digamesystems/HD_Remote_Clone/docs/images/enclosure/enclosure_pcb_outline.dxf

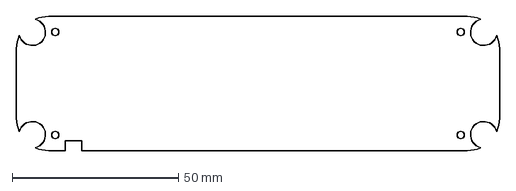
[picture p13: CAD file, 2026-11-13]
docs/images/enclosure/enclosure_pcb_outline.dxf
145.4 x 40.4 mm
