digamesystems/HD_Remote_Clone/TESTING.md

# Testing

Tests are split into three tiers by what they need to run. That decides when they can block a deploy.

## Tier 1: host unit tests (no hardware)

```
pio test -e native
```

These run on the PC with Unity and the MSYS2 gcc compiler, and take seconds. They cover hardware-independent logic in [`lib/hdcore/`](lib/hdcore/src), which the firmware and the tests share.

| Suite | Covers |
|---|---|
| `test_native_parse` | serial command tokenizing, hex parsing, data-rate parsing |
| `test_native_rf` | nRF24 on-air ↔ register address byte order, sniffer duplicate filter, Platinum RF payload decoding, packet runs (counts, gaps, idle flush, `micros()` wrap) |
| `test_native_ir` | HD IR frame encode/decode: layout, period, round trip of all 16 codes, decoding of real captured frames (including phase-shifted and truncated ones) |

**Rule:** logic that can run without hardware goes in `lib/hdcore/`, with a Tier 1 test, rather than in `src/`. This includes protocol encoding, IR frame analysis and state machines.

## Tier 2: on-device tests (ESP32, extra hardware optional)

```
pio test -e esp32dev_test --upload-port COM11                         # all device suites
pio test -e esp32dev_test --upload-port COM11 -f test_device_ir       # one suite
```

These flash a **test firmware** to the board, run Unity on it and report over serial. Afterwards the board is left running the test firmware, so re-upload the app (`pio run -t upload`).

[`include/hw_config.h`](include/hw_config.h) declares what's wired on the breadboard:

- Hardware declared **absent**: the test is **IGNORED** and reported as *not verified*.
- Hardware declared **present**: the test **must pass**. A failure blocks deploy.

Update `hw_config.h` whenever the breadboard changes. We can add loopbacks or other diagnostic wiring to make hardware testable.

| Suite | Needs | Covers |
|---|---|---|
| `test_device_board` | board only | chip is the original ESP32 (D0WD), no PSRAM (so not WROVER), flash ≥ 4 MB |
| `test_device_rf` | `HW_NRF24` (+ `HW_NRF24_B` for loopback) | `begin()`, `isChipConnected()`, 200× register read-back at 1 and 2 Mbps, Platinum RX config applies; loopback: radio B → main radio at the Platinum settings, ≥ 45/50 packets on each of ch 33, 52, 71 |
| `test_device_ir` | `HW_IR_LOOPBACK` | TSAL6200 → receiver round trip of a synthetic frame within ±max(200 µs, 25%); 10/10 reliability; HD UP/DOWN bursts decode correctly |

A loopback between two clone modules shows the sniffer works, but not that it hears the original remote, whose frames may differ in detail; acceptance A4 (group-mode sniff) is the real check. Planned: button and deep-sleep wake tests (`HW_BUTTONS`).

**Implementation note:** `pio test` defines `UNIT_TEST`, which switches IRremoteESP8266 into a host-stub mode. [`scripts/no_unit_test_define.py`](scripts/no_unit_test_define.py) strips that define for the ESP32 environments so device tests use the real library.

## Tier 3: manual acceptance (real shades, original remote)

These can't be automated. A feature is **done** once John confirms it and it's recorded below.

| # | Check | Result | Date |
|---|---|---|---|
| A1 | Capture IR from the original remote in red mode, every button | ✅ Format decoded; UP = 0101, DOWN = 0110 (log + analyzer); no other button sends IR (analyzer) | 2026-11-07 |
| A2 | Replay a captured IR code; target shade responds | ✅ With the original remote's RF present (remote aimed away): shade moves both ways and follows the clone when the two disagree. Clone alone: 0 of 20 (see docs/IR_PROTOCOL.md, Shade tests) | 2026-11-09 |
| A3 | RF scan shows the original remote's channels | ⏳ ch 33 confirmed by exact-match sniff (both remotes); 52 / 71 not checked; `scan` not run | 2026-11-11 |
| A4 | Sniffer decodes the original remote's group up/down/release packets | ⏳ group 1 UP held + release decoded from both remotes (docs/RF_PROTOCOL.md). DOWN not sniffed | 2026-11-11 |
| A6 | Clone RF group commands move the shades | ✅ `grp`: groups 1–4 independently and All, UP and DOWN, no original remote | 2026-11-11 |
| A7 | Clone pairs with a shade under its own ID | ⏳ `pair 4 add` with a made-up ID: the shade jogged, then `grp 4` worked 5/5 up and 5/5 down (none before pairing). `pair 4 remove` not tested | 2026-11-12 |
| A5 | RF-wake hypothesis: IR replay alone vs. with RF burst | ✅ Confirmed by two tests: clone IR alone 0/20, clone IR + remote RF works; remote's IR fails when a foil tube blocks its RF. RF captured 2026-11-11 (`ID 01 00 80`, docs/RF_PROTOCOL.md); our own wake + IR moves the shade with no original remote, reliably at ~1 ft (2026-11-11) | 2026-11-11 |

## Gate rules

Day-to-day development uses fast, ungated steps; the full gate runs on a release (`cpdt`). The shorthand commands are defined in [CLAUDE.md](CLAUDE.md).

| Step | Must pass |
|---|---|
| Deploy for a quick try (`d`) | `pio run` builds (no tests) |
| Commit (`c`) | `pio run` builds (no tests) |
| **Gated release (`cpdt`)** | build + **all** Tier 1 suites + Tier 2 suites for `board` and the areas changed (`-f test_device_<area>`), then commit, push and upload the app |
| Feature "done" | its Tier 3 row confirmed |

Ungated commits may reach GitHub between releases; `cpdt` is what certifies a build. If any required step fails: **halt**. No commit, push or deploy. Report the failure.

If Tier 2 tests are ignored because hardware is absent, the build may still be deployed, but the report must say plainly which areas were **not verified**.
