digamesystems/HD_Remote_Clone/hardware/hd_remote/hd_remote.kicad_pcb

## KiCad design hardware/hd_remote/hd_remote.kicad_pcb (2026-11-14)

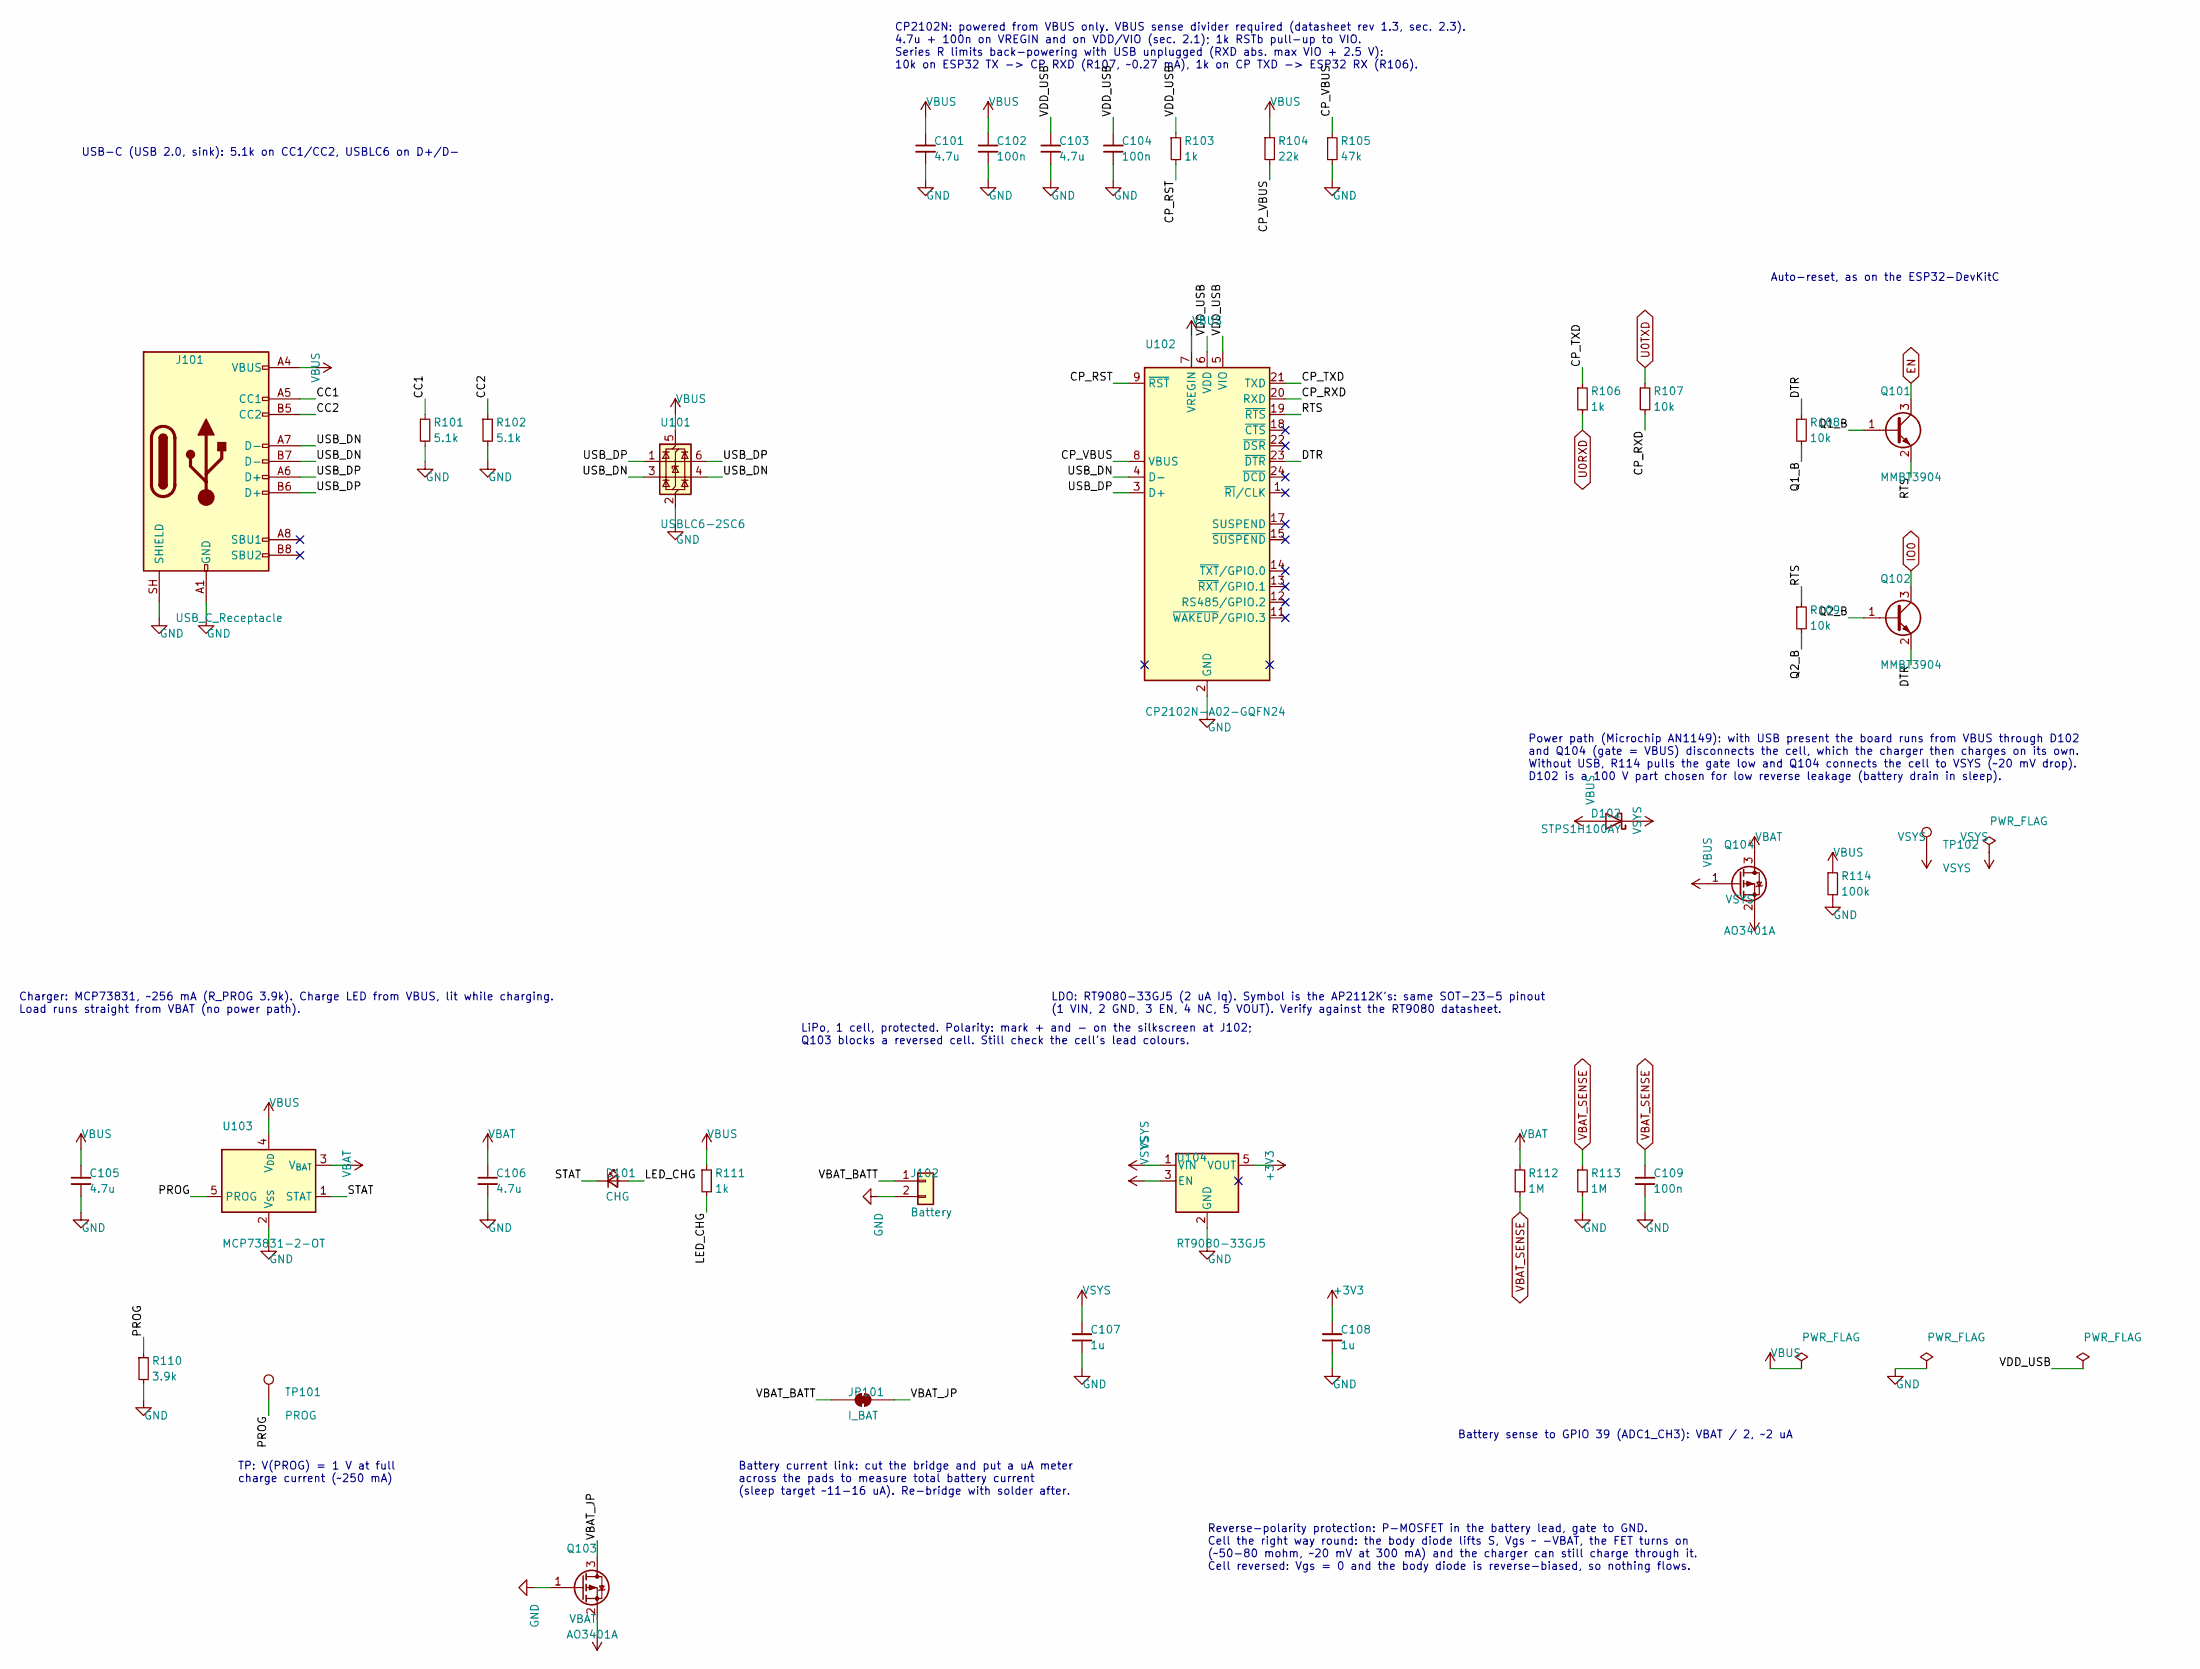
[picture p15: schematic power_usb.kicad_sch, HD Platinum remote replacement: Power and USB]

Parts:
C101, C103, C105, C106: 4.7u; C_0603_1608Metric; LCSC C19666
C102, C104, C109: 100n; C_0603_1608Metric; LCSC C14663
C107, C108: 1u; C_0603_1608Metric; LCSC C15849
D101: CHG; LED_0603_1608Metric; LCSC C2286
D102: STPS1H100AY; D_SMA; MPN STPS1H100AY; LCSC C181833
J101: USB_C_Receptacle; USB_C_Receptacle_HRO_TYPE-C-31-M-12; LCSC C165948
J102: Battery; JST_PH_S2B-PH-K_1x02_P2.00mm_Horizontal; LCSC C173752
JP101: I_BAT; SolderJumper-2_P1.3mm_Bridged_RoundedPad1.0x1.5mm
Q101, Q102: MMBT3904; SOT-23; LCSC C20526
Q103, Q104: AO3401A; SOT-23; LCSC C15127
R101, R102: 5.1k; R_0603_1608Metric; LCSC C23186
R103, R106, R111: 1k; R_0603_1608Metric; LCSC C21190
R104: 22k; R_0603_1608Metric; LCSC C31850
R105: 47k; R_0603_1608Metric; LCSC C25819
R107, R108, R109: 10k; R_0603_1608Metric; LCSC C25804
R110: 3.9k; R_0603_1608Metric; LCSC C23018
R112, R113: 1M; R_0603_1608Metric; LCSC C22935
R114: 100k; R_0603_1608Metric; LCSC C25803
TP101: PROG; TestPoint_Pad_D1.5mm
TP102: VSYS; TestPoint_Pad_D1.5mm
U101: USBLC6-2SC6; SOT-23-6; LCSC C7519
U102: CP2102N-A02-GQFN24; QFN-24-1EP_4x4mm_P0.5mm_EP2.6x2.6mm; LCSC C969151
U103: MCP73831-2-OT; SOT-23-5; LCSC C424093
U104: RT9080-33GJ5; SOT-23-5; LCSC C841192

Connections:
+3V3: C108.1, U104.5 (VOUT); also elsewhere on the board
/Power and USB/CC1: J101.A5 (CC1), R101.1
/Power and USB/CC2: J101.B5 (CC2), R102.1
/Power and USB/CP_RST: R103.2, U102.9 (~RST)
/Power and USB/CP_RXD: R107.2, U102.20 (RXD)
/Power and USB/CP_TXD: R106.1, U102.21 (TXD)
/Power and USB/CP_VBUS: R104.2, R105.1, U102.8 (VBUS)
/Power and USB/DTR: Q102.2 (E), R108.1, U102.23 (~DTR)
/Power and USB/LED_CHG: D101.2 (A), R111.2
/Power and USB/PROG: R110.1, TP101.1, U103.5 (PROG)
/Power and USB/Q1_B: Q101.1 (B), R108.2
/Power and USB/Q2_B: Q102.1 (B), R109.2
/Power and USB/RTS: Q101.2 (E), R109.1, U102.19 (~RTS)
/Power and USB/STAT: D101.1 (K), U103.1 (STAT)
/Power and USB/USB_DN: J101.A7 (D-), J101.B7 (D-), U101.3 (I/O2), U101.4 (I/O2), U102.4 (D-)
/Power and USB/USB_DP: J101.A6 (D+), J101.B6 (D+), U101.1 (I/O1), U101.6 (I/O1), U102.3 (D+)
/Power and USB/VBAT_BATT: J102.1, JP101.1 (A)
/Power and USB/VBAT_JP: JP101.2 (B), Q103.3 (D)
/Power and USB/VDD_USB: C103.1, C104.1, R103.1, U102.5 (VIO), U102.6 (VDD)
EN: Q101.3 (C); also elsewhere on the board
GND: C101.2, C102.2, C103.2, C104.2, C105.2, C106.2, C107.2, C108.2, C109.2, J101.A1 (GND), J101.A12 (GND), J101.B1 (GND), J101.B12 (GND), J101.SH (SHIELD), J102.2, Q103.1 (G), R101.2, R102.2, R105.2, R110.2, R113.2, R114.2, U101.2 (GND), U102.2 (GND), U102.25 (GND), U103.2 (V_{SS}), U104.2 (GND); also elsewhere on the board
IO0: Q102.3 (C); also elsewhere on the board
U0RXD: R106.2; also elsewhere on the board
U0TXD: R107.1; also elsewhere on the board
VBAT: C106.1, Q103.2 (S), Q104.3 (D), R112.1, U103.3 (V_{BAT}); also elsewhere on the board
VBAT_SENSE: C109.1, R112.2, R113.1; also elsewhere on the board
VBUS: C101.1, C102.1, C105.1, D102.2 (A), J101.A4 (VBUS), J101.A9 (VBUS), J101.B4 (VBUS), J101.B9 (VBUS), Q104.1 (G), R104.1, R111.1, R114.1, U101.5 (VBUS), U102.7 (VREGIN), U103.4 (V_{DD}); also elsewhere on the board
VSYS: C107.1, D102.1 (K), Q104.2 (S), TP102.1, U104.1 (VIN), U104.3 (EN); also elsewhere on the board

Notes on the sheet:
Reverse-polarity protection: P-MOSFET in the battery lead, gate to GND. Cell the right way round: the body diode lifts S, Vgs ~ -VBAT, the FET turns on (~50-80 mohm, ~20 mV at 300 mA) and the charger can still charge through it. Cell reversed: Vgs = 0 and the body diode is reverse-biased, so nothin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
Battery current link: cut the bridge and put a uA meter across the pads to measure total battery current (sleep target ~11-16 uA). Re-bridge with solder after.
CP2102N: powered from VBUS only. VBUS sense divider required (datasheet rev 1.3, sec. 2.3). 4.7u + 100n on VREGIN and on VDD/VIO (sec. 2.1); 1k RSTb pull-up to VIO. Series R limits back-powering with USB unplugged (RXD abs. max VIO + 2.5 V): 10k on ESP32 TX -> CP RXD (R107, ~0.27 mA), 1k on CP TXD 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
Auto-reset, as on the ESP32-DevKitC
Charger: MCP73831, ~256 mA (R_PROG 3.9k). Charge LED from VBUS, lit while charging. Load runs straight from VBAT (no power path).
Power path (Microchip AN1149): with USB present the board runs from VBUS through D102 and Q104 (gate = VBUS) disconnects the cell, which the charger then charges on its own. Without USB, R114 pulls the gate low and Q104 connects the cell to VSYS (~20 mV drop). D102 is a 100 V part chosen for low re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
USB-C (USB 2.0, sink): 5.1k on CC1/CC2, USBLC6 on D+/D-
LiPo, 1 cell, protected. Polarity: mark + and - on the silkscreen at J102; Q103 blocks a reversed cell. Still check the cell's lead colours.
Battery sense to GPIO 39 (ADC1_CH3): VBAT / 2, ~2 uA
LDO: RT9080-33GJ5 (2 uA Iq). Symbol is the AP2112K's: same SOT-23-5 pinout (1 VIN, 2 GND, 3 EN, 4 NC, 5 VOUT). Verify against the RT9080 datasheet.
TP: V(PROG) = 1 V at full charge current (~250 mA)

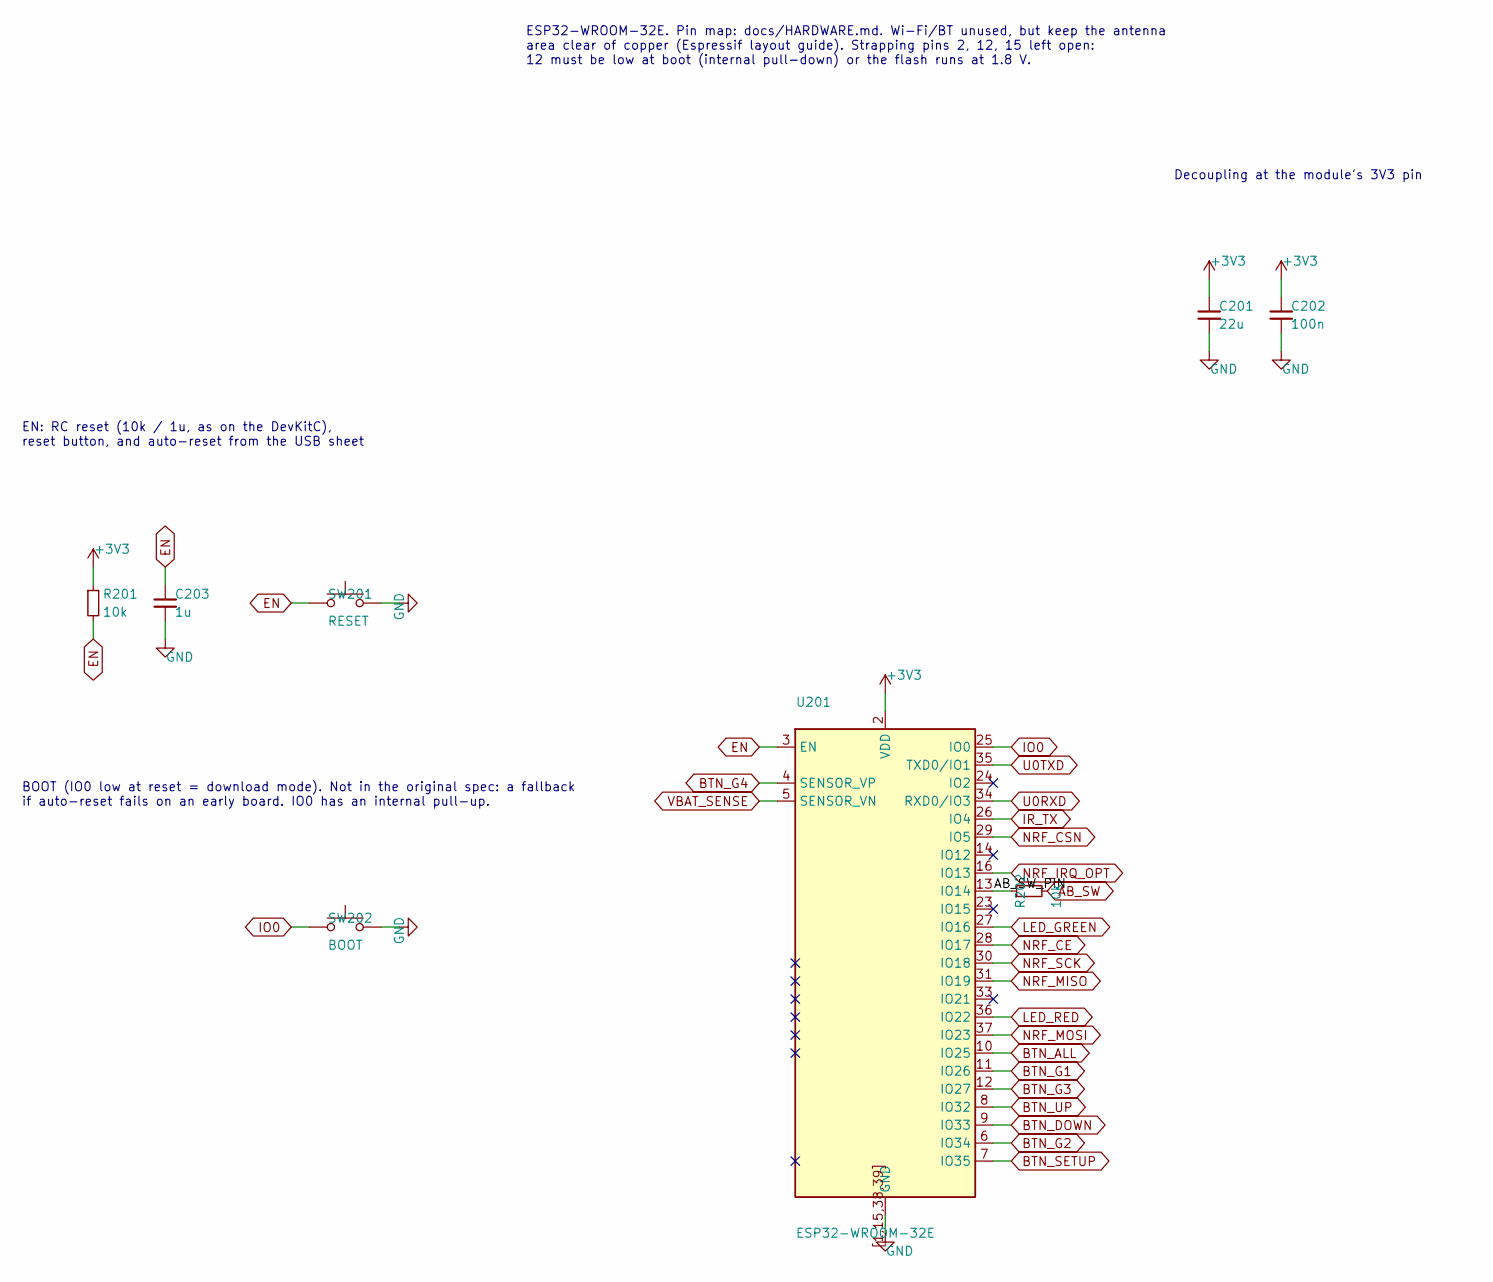
[picture p16: schematic mcu.kicad_sch, HD Platinum remote replacement: MCU]

Parts:
C201: 22u; C_0805_2012Metric; LCSC C45783
C202: 100n; C_0603_1608Metric; LCSC C14663
C203: 1u; C_0603_1608Metric; LCSC C15849
R201, R202: 10k; R_0603_1608Metric; LCSC C25804
SW201: RESET; SW_Push_1P1T_NO_CK_KMR2; LCSC C269272
SW202: BOOT; SW_Push_1P1T_NO_CK_KMR2; LCSC C269272
U201: ESP32-WROOM-32E; LCSC C701341

Connections:
+3V3: C201.1, C202.1, R201.1, U201.2 (VDD); also elsewhere on the board
/MCU/AB_SW_PIN: R202.1, U201.13 (IO14)
AB_SW: R202.2; also elsewhere on the board
BTN_ALL: U201.10 (IO25); also elsewhere on the board
BTN_DOWN: U201.9 (IO33); also elsewhere on the board
BTN_G1: U201.11 (IO26); also elsewhere on the board
BTN_G2: U201.6 (IO34); also elsewhere on the board
BTN_G3: U201.12 (IO27); also elsewhere on the board
BTN_G4: U201.4 (SENSOR_VP); also elsewhere on the board
BTN_SETUP: U201.7 (IO35); also elsewhere on the board
BTN_UP: U201.8 (IO32); also elsewhere on the board
EN: C203.1, R201.2, SW201.1, U201.3 (EN); also elsewhere on the board
GND: C201.2, C202.2, C203.2, SW201.2, SW202.2, U201.1, U201.15, U201.38, U201.39, U201.[1,15,38,39] (GND); also elsewhere on the board
IO0: SW202.1, U201.25 (IO0); also elsewhere on the board
IR_TX: U201.26 (IO4); also elsewhere on the board
LED_GREEN: U201.27 (IO16); also elsewhere on the board
LED_RED: U201.36 (IO22); also elsewhere on the board
NRF_CE: U201.28 (IO17); also elsewhere on the board
NRF_CSN: U201.29 (IO5); also elsewhere on the board
NRF_IRQ_OPT: U201.16 (IO13); also elsewhere on the board
NRF_MISO: U201.31 (IO19); also elsewhere on the board
NRF_MOSI: U201.37 (IO23); also elsewhere on the board
NRF_SCK: U201.30 (IO18); also elsewhere on the board
U0RXD: U201.34 (RXD0/IO3); also elsewhere on the board
U0TXD: U201.35 (TXD0/IO1); also elsewhere on the board
VBAT_SENSE: U201.5 (SENSOR_VN); also elsewhere on the board

Notes on the sheet:
EN: RC reset (10k / 1u, as on the DevKitC), reset button, and auto-reset from the USB sheet
Decoupling at the module's 3V3 pin
BOOT (IO0 low at reset = download mode). Not in the original spec: a fallback if auto-reset fails on an early board. IO0 has an internal pull-up.
ESP32-WROOM-32E. Pin map: docs/HARDWARE.md. Wi-Fi/BT unused, but keep the antenna area clear of copper (Espressif layout guide). Strapping pins 2, 12, 15 left open: 12 must be low at boot (internal pull-down) or the flash runs at 1.8 V.

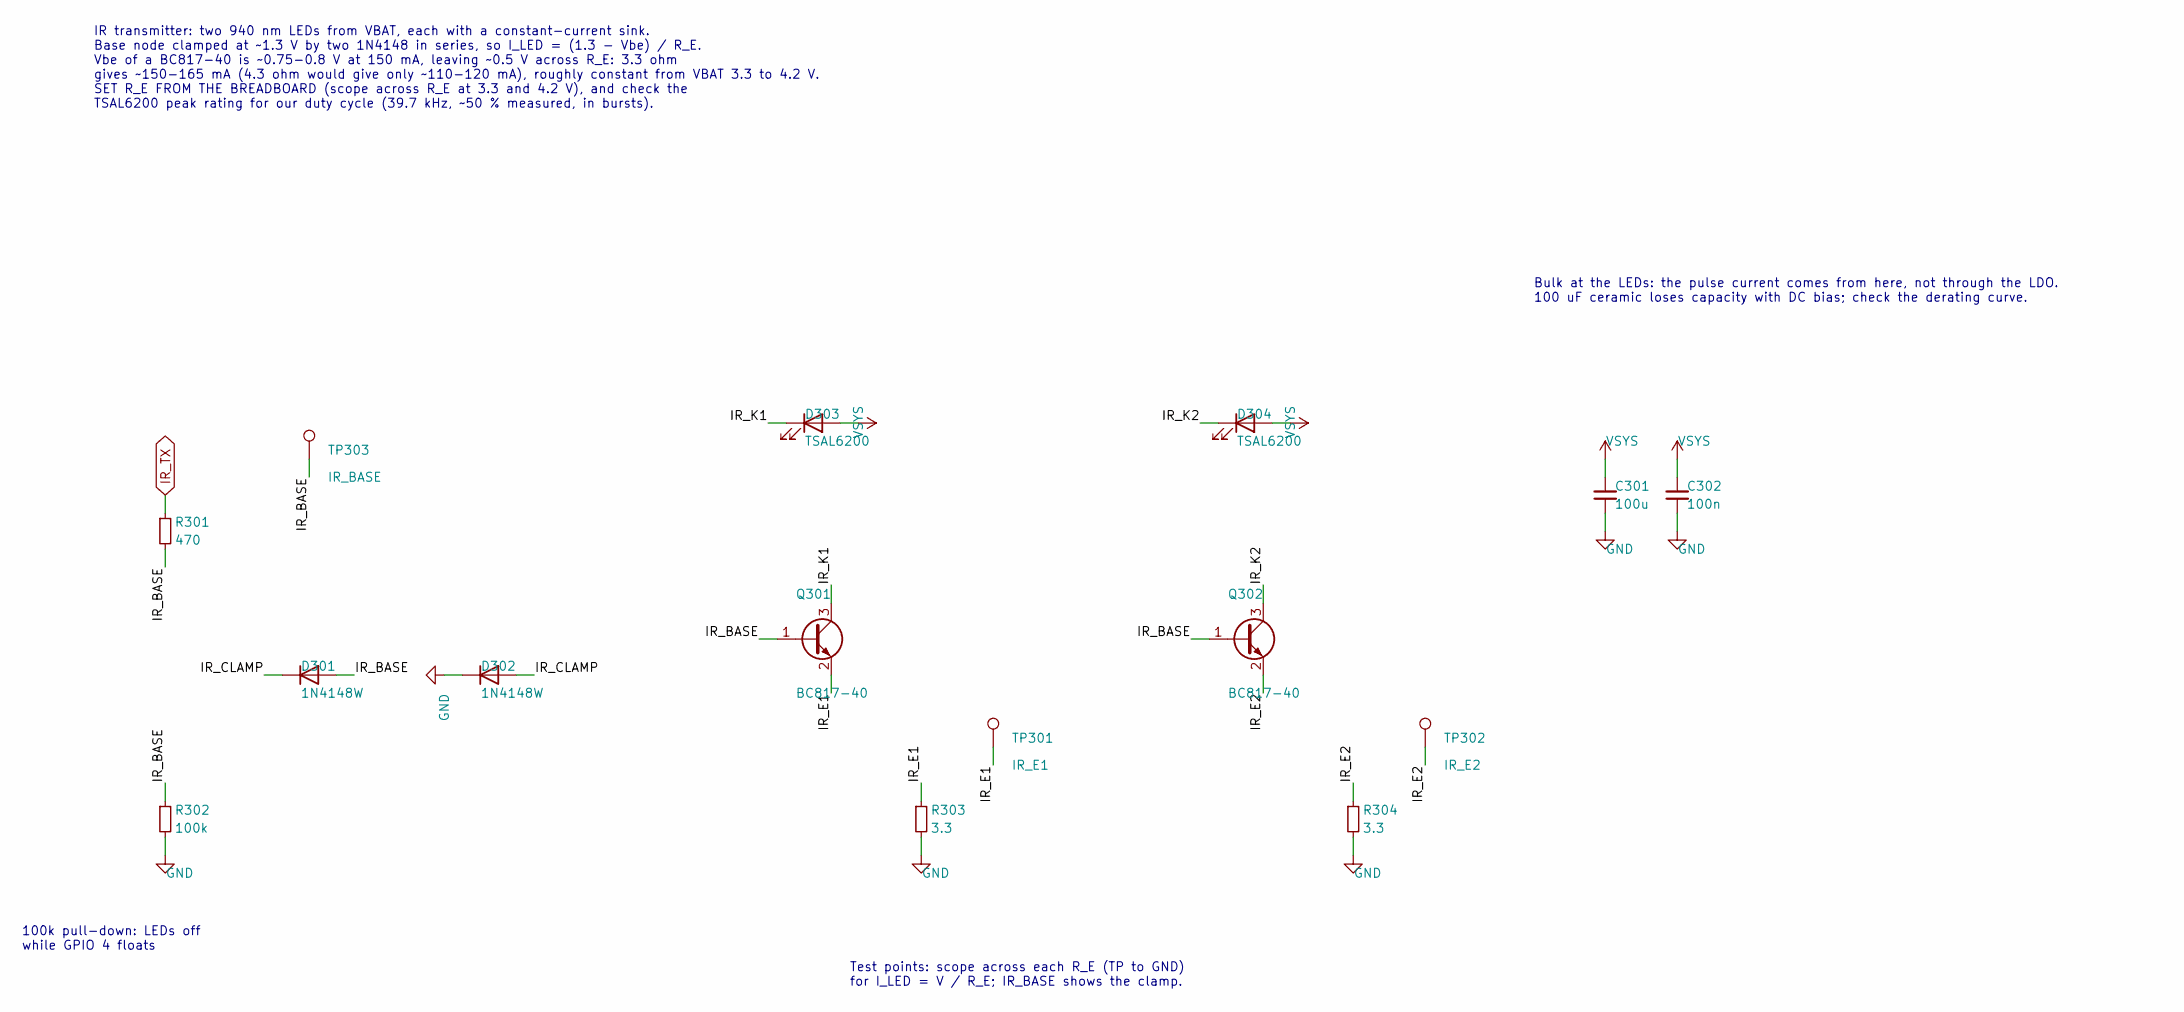
[picture p17: schematic ir.kicad_sch, HD Platinum remote replacement: IR]

Parts:
C301: 100u; C_1206_3216Metric; LCSC C15008
C302: 100n; C_0603_1608Metric; LCSC C14663
D301, D302: 1N4148W; D_SOD-123; LCSC C81598
D303, D304: TSAL6200; LED_D5.0mm_Horizontal_O1.27mm_Z3.0mm
Q301, Q302: BC817-40; SOT-23; LCSC C52801
R301: 470; R_0603_1608Metric; LCSC C23179
R302: 100k; R_0603_1608Metric; LCSC C25803
R303, R304: 3.3; R_0805_2012Metric; LCSC C2907250
TP301: IR_E1; TestPoint_Pad_D1.5mm
TP302: IR_E2; TestPoint_Pad_D1.5mm
TP303: IR_BASE; TestPoint_Pad_D1.5mm

Connections:
/IR/IR_BASE: D301.2 (A), Q301.1 (B), Q302.1 (B), R301.2, R302.1, TP303.1
/IR/IR_CLAMP: D301.1 (K), D302.2 (A)
/IR/IR_E1: Q301.2 (E), R303.1, TP301.1
/IR/IR_E2: Q302.2 (E), R304.1, TP302.1
/IR/IR_K1: D303.1 (K), Q301.3 (C)
/IR/IR_K2: D304.1 (K), Q302.3 (C)
GND: C301.2, C302.2, D302.1 (K), R302.2, R303.2, R304.2; also elsewhere on the board
IR_TX: R301.1; also elsewhere on the board
VSYS: C301.1, C302.1, D303.2 (A), D304.2 (A); also elsewhere on the board

Notes on the sheet:
100k pull-down: LEDs off while GPIO 4 floats
IR transmitter: two 940 nm LEDs from VBAT, each with a constant-current sink. Base node clamped at ~1.3 V by two 1N4148 in series, so I_LED = (1.3 - Vbe) / R_E. Vbe of a BC817-40 is ~0.75-0.8 V at 150 mA, leaving ~0.5 V across R_E: 3.3 ohm gives ~150-165 mA (4.3 ohm would give only ~110-120 mA), ro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
Test points: scope across each R_E (TP to GND) for I_LED = V / R_E; IR_BASE shows the clamp.
Bulk at the LEDs: the pulse current comes from here, not through the LDO. 100 uF ceramic loses capacity with DC bias; check the derating curve.

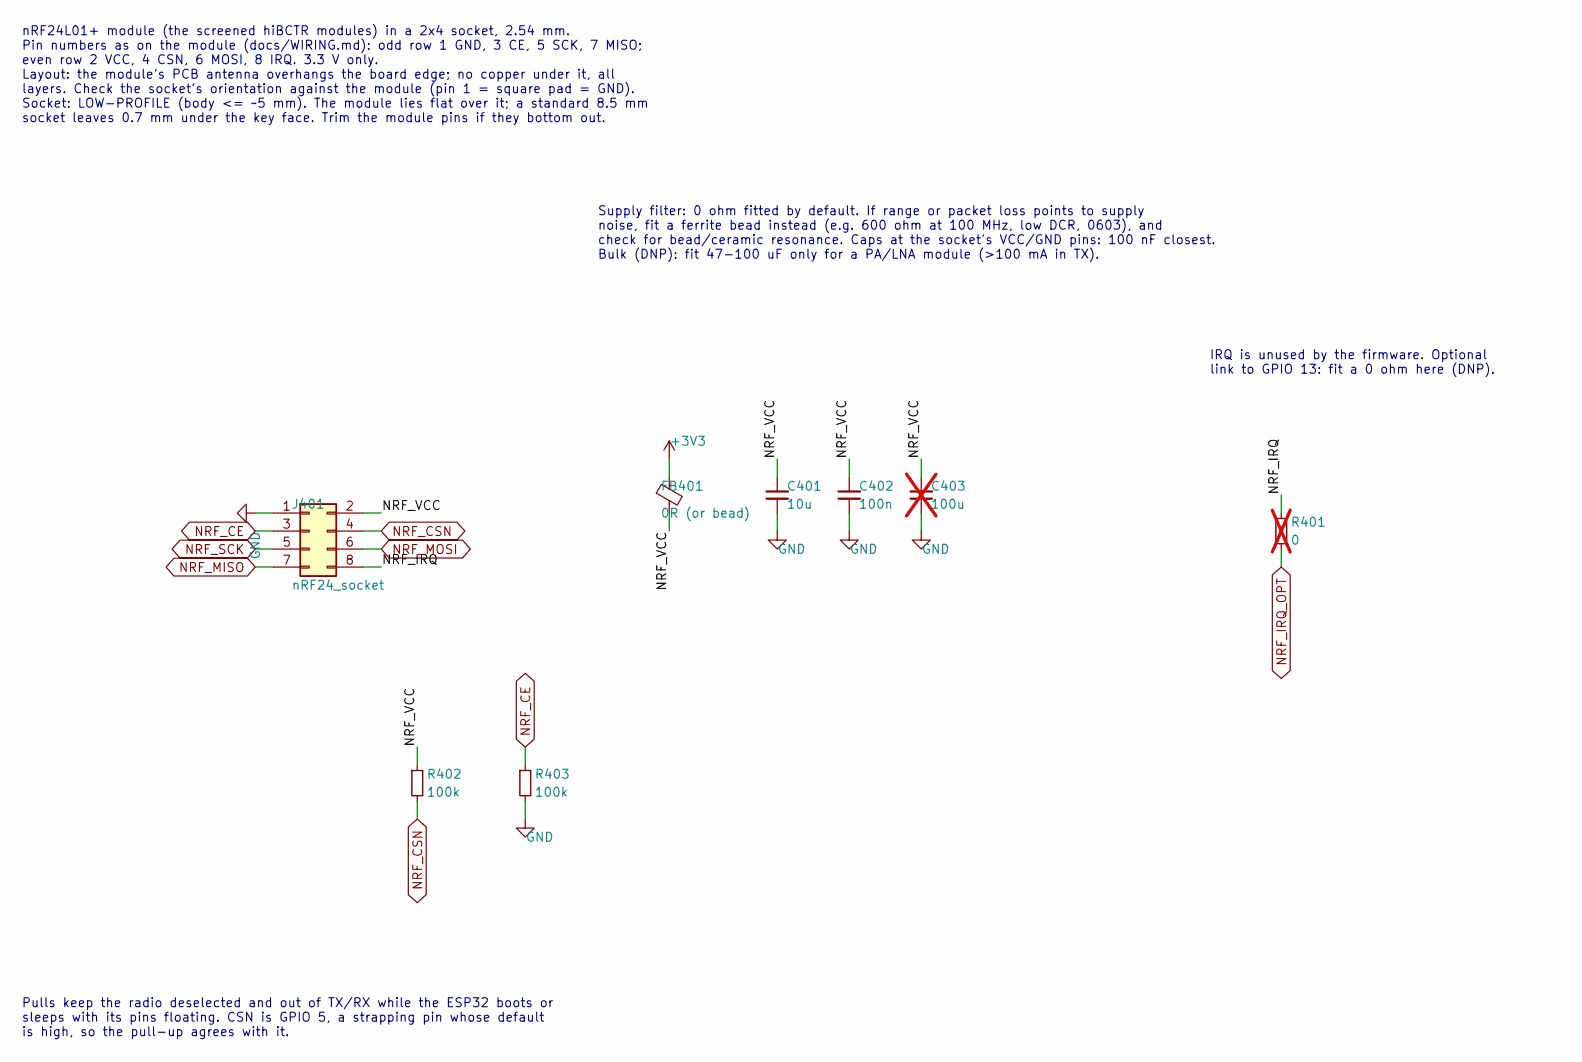
[picture p18: schematic nrf24.kicad_sch, HD Platinum remote replacement: nRF24]

Parts:
C401: 10u; C_0805_2012Metric; LCSC C15850
C402: 100n; C_0603_1608Metric; LCSC C14663
C403: 100u; C_1206_3216Metric; LCSC C15008; not fitted
FB401: 0R (or bead); L_0603_1608Metric; LCSC C21189
J401: nRF24_socket; PinSocket_2x04_P2.54mm_Vertical
R401: 0; R_0603_1608Metric; LCSC C21189; not fitted
R402, R403: 100k; R_0603_1608Metric; LCSC C25803

Connections:
+3V3: FB401.1; also elsewhere on the board
/nRF24/NRF_IRQ: J401.8, R401.1
/nRF24/NRF_VCC: C401.1, C402.1, C403.1, FB401.2, J401.2, R402.1
GND: C401.2, C402.2, C403.2, J401.1, R403.2; also elsewhere on the board
NRF_CE: J401.3, R403.1; also elsewhere on the board
NRF_CSN: J401.4, R402.2; also elsewhere on the board
NRF_IRQ_OPT: R401.2; also elsewhere on the board
NRF_MISO: J401.7; also elsewhere on the board
NRF_MOSI: J401.6; also elsewhere on the board
NRF_SCK: J401.5; also elsewhere on the board

Notes on the sheet:
IRQ is unused by the firmware. Optional link to GPIO 13: fit a 0 ohm here (DNP).
Supply filter: 0 ohm fitted by default. If range or packet loss points to supply noise, fit a ferrite bead instead (e.g. 600 ohm at 100 MHz, low DCR, 0603), and check for bead/ceramic resonance. Caps at the socket's VCC/GND pins: 100 nF closest. Bulk (DNP): fit 47-100 uF only for a PA/LNA module (>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
Pulls keep the radio deselected and out of TX/RX while the ESP32 boots or sleeps with its pins floating. CSN is GPIO 5, a strapping pin whose default is high, so the pull-up agrees with it.
nRF24L01+ module (the screened hiBCTR modules) in a 2x4 socket, 2.54 mm. Pin numbers as on the module (docs/WIRING.md): odd row 1 GND, 3 CE, 5 SCK, 7 MISO; even row 2 VCC, 4 CSN, 6 MOSI, 8 IRQ. 3.3 V only. Layout: the module's PCB antenna overhangs the board edge; no copper under it, all layers. Ch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

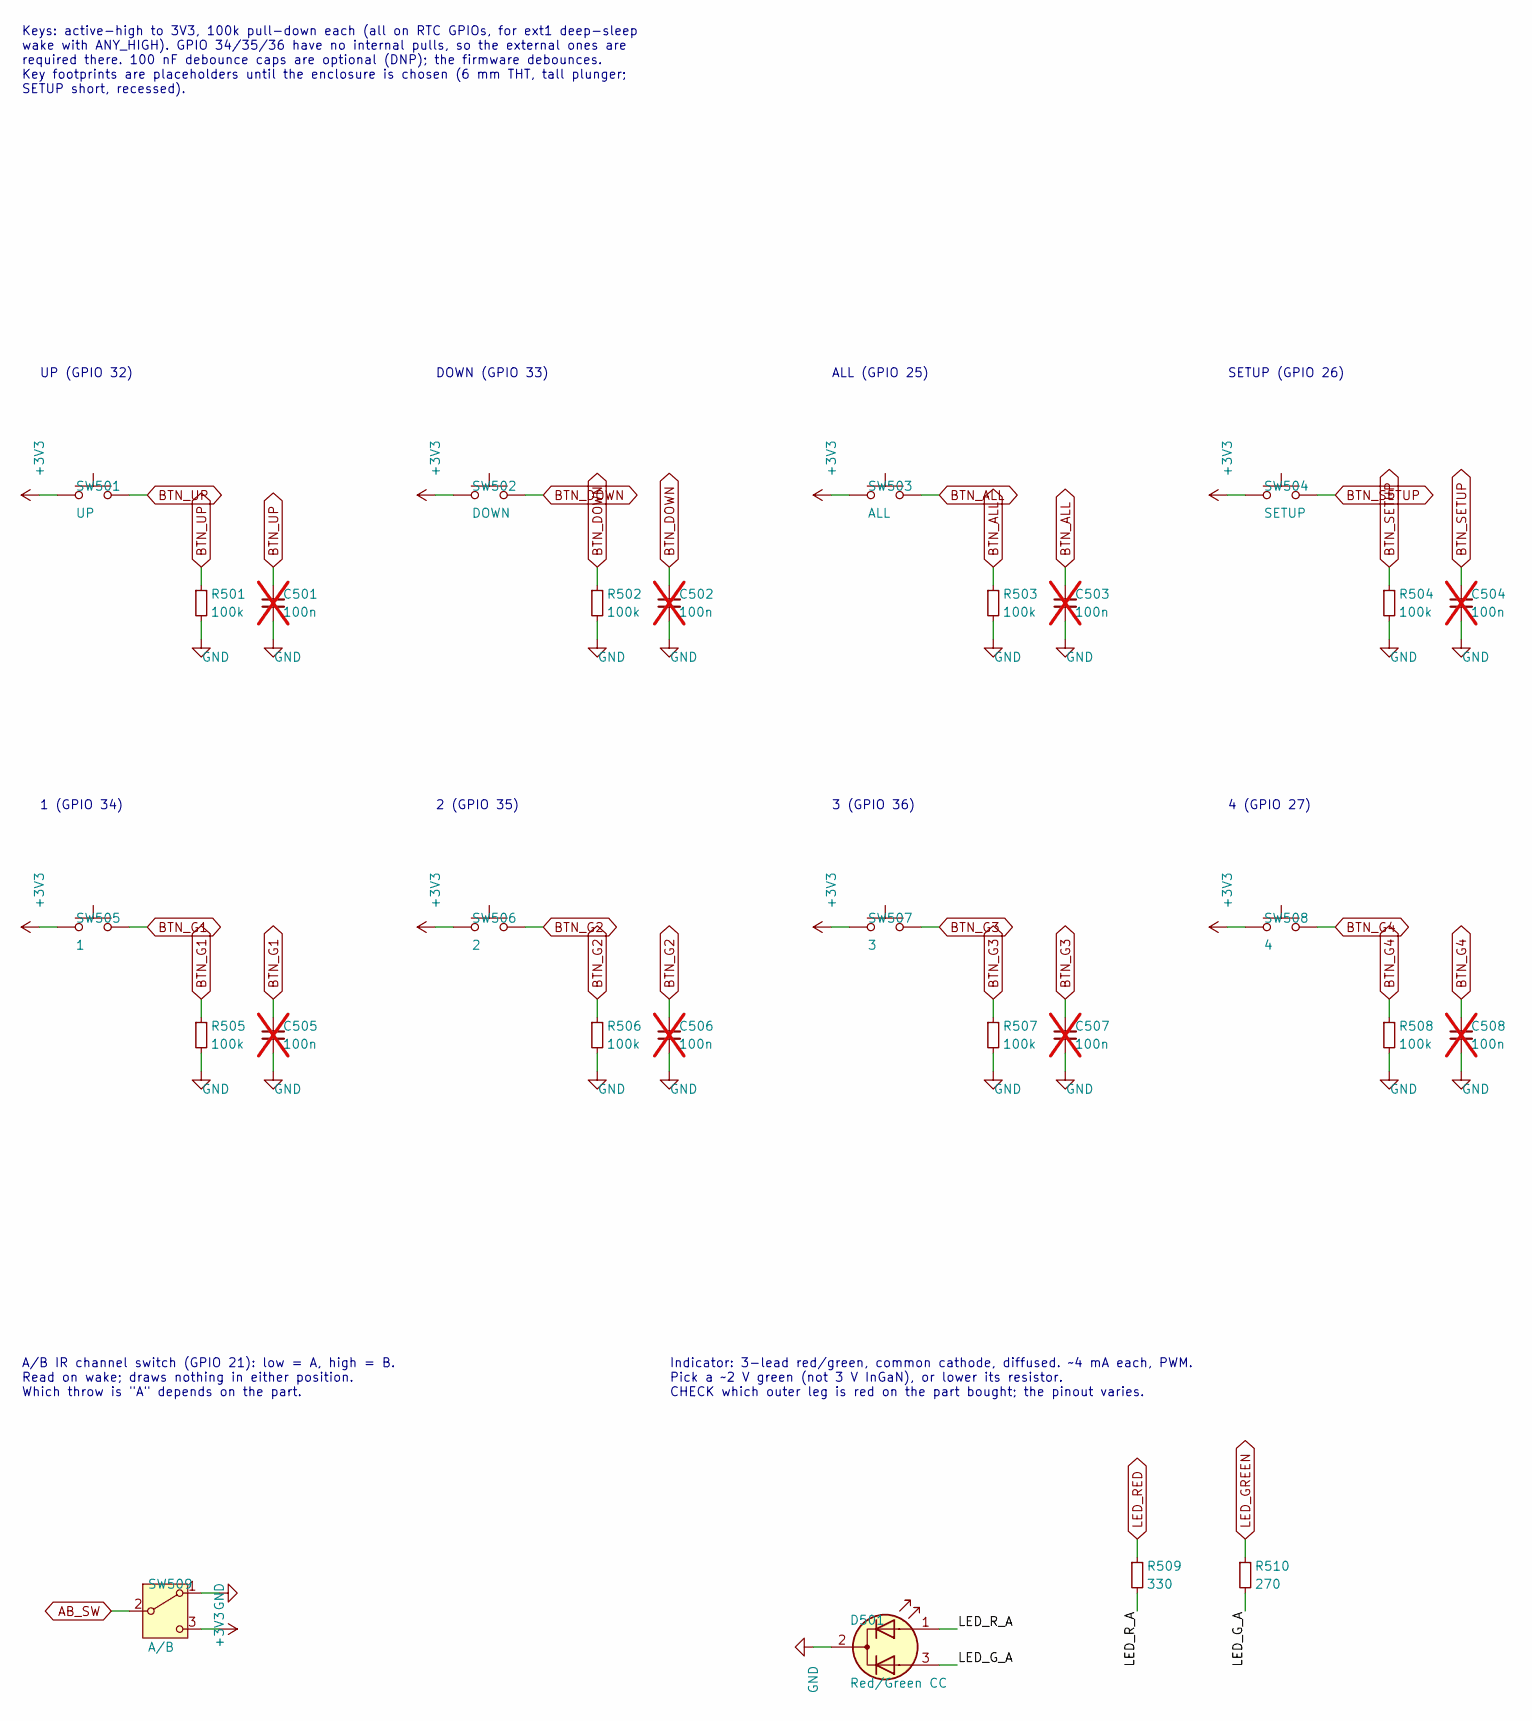
[picture p19: schematic ui.kicad_sch, HD Platinum remote replacement: Buttons and LEDs]

Parts:
C501, C502, C503, C504, C505, C506, C507, C508: 100n; C_0603_1608Metric; LCSC C14663; not fitted
D501: Red/Green CC; LED_D5.0mm-3
R501, R502, R503, R504, R505, R506, R507, R508: 100k; R_0603_1608Metric; LCSC C25803
R509: 330; R_0603_1608Metric; LCSC C23138
R510: 270; R_0603_1608Metric; LCSC C22966
SW501: UP; SW_PUSH_6mm_H13mm; MPN TS02-66-130-BK-160-SCR-D
SW502: DOWN; SW_PUSH_6mm_H13mm; MPN TS02-66-130-BK-160-SCR-D
SW503: ALL; SW_PUSH_6mm_H13mm; MPN TS02-66-130-BK-160-SCR-D
SW504: SETUP; SW_PUSH_6mm_H5mm; MPN TS02-66-50-BK-160-SCR-D
SW505: 1; SW_PUSH_6mm_H13mm; MPN TS02-66-130-BK-160-SCR-D
SW506: 2; SW_PUSH_6mm_H13mm; MPN TS02-66-130-BK-160-SCR-D
SW507: 3; SW_PUSH_6mm_H13mm; MPN TS02-66-130-BK-160-SCR-D
SW508: 4; SW_PUSH_6mm_H13mm; MPN TS02-66-130-BK-160-SCR-D
SW509: A/B; SW_SPDT_PCM12; LCSC C221841

Connections:
+3V3: SW501.1, SW502.1, SW503.1, SW504.1, SW505.1, SW506.1, SW507.1, SW508.1, SW509.3 (C); also elsewhere on the board
/Buttons and LEDs/LED_G_A: D501.3 (A2), R510.2
/Buttons and LEDs/LED_R_A: D501.1 (A1), R509.2
AB_SW: SW509.2 (B); also elsewhere on the board
BTN_ALL: C503.1, R503.1, SW503.2; also elsewhere on the board
BTN_DOWN: C502.1, R502.1, SW502.2; also elsewhere on the board
BTN_G1: C505.1, R505.1, SW505.2; also elsewhere on the board
BTN_G2: C506.1, R506.1, SW506.2; also elsewhere on the board
BTN_G3: C507.1, R507.1, SW507.2; also elsewhere on the board
BTN_G4: C508.1, R508.1, SW508.2; also elsewhere on the board
BTN_SETUP: C504.1, R504.1, SW504.2; also elsewhere on the board
BTN_UP: C501.1, R501.1, SW501.2; also elsewhere on the board
GND: C501.2, C502.2, C503.2, C504.2, C505.2, C506.2, C507.2, C508.2, D501.2 (K), R501.2, R502.2, R503.2, R504.2, R505.2, R506.2, R507.2, R508.2, SW509.1 (A); also elsewhere on the board
LED_GREEN: R510.1; also elsewhere on the board
LED_RED: R509.1; also elsewhere on the board

Notes on the sheet:
A/B IR channel switch (GPIO 21): low = A, high = B. Read on wake; draws nothing in either position. Which throw is "A" depends on the part.
2 (GPIO 35)
Indicator: 3-lead red/green, common cathode, diffused. ~4 mA each, PWM. Pick a ~2 V green (not 3 V InGaN), or lower its resistor. CHECK which outer leg is red on the part bought; the pinout varies.
1 (GPIO 34)
Keys: active-high to 3V3, 100k pull-down each (all on RTC GPIOs, for ext1 deep-sleep wake with ANY_HIGH). GPIO 34/35/36 have no internal pulls, so the external ones are required there. 100 nF debounce caps are optional (DNP); the firmware debounces. Key footprints are placeholders until the enclosu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
DOWN (GPIO 33)
3 (GPIO 36)
UP (GPIO 32)
SETUP (GPIO 26)
4 (GPIO 27)
ALL (GPIO 25)

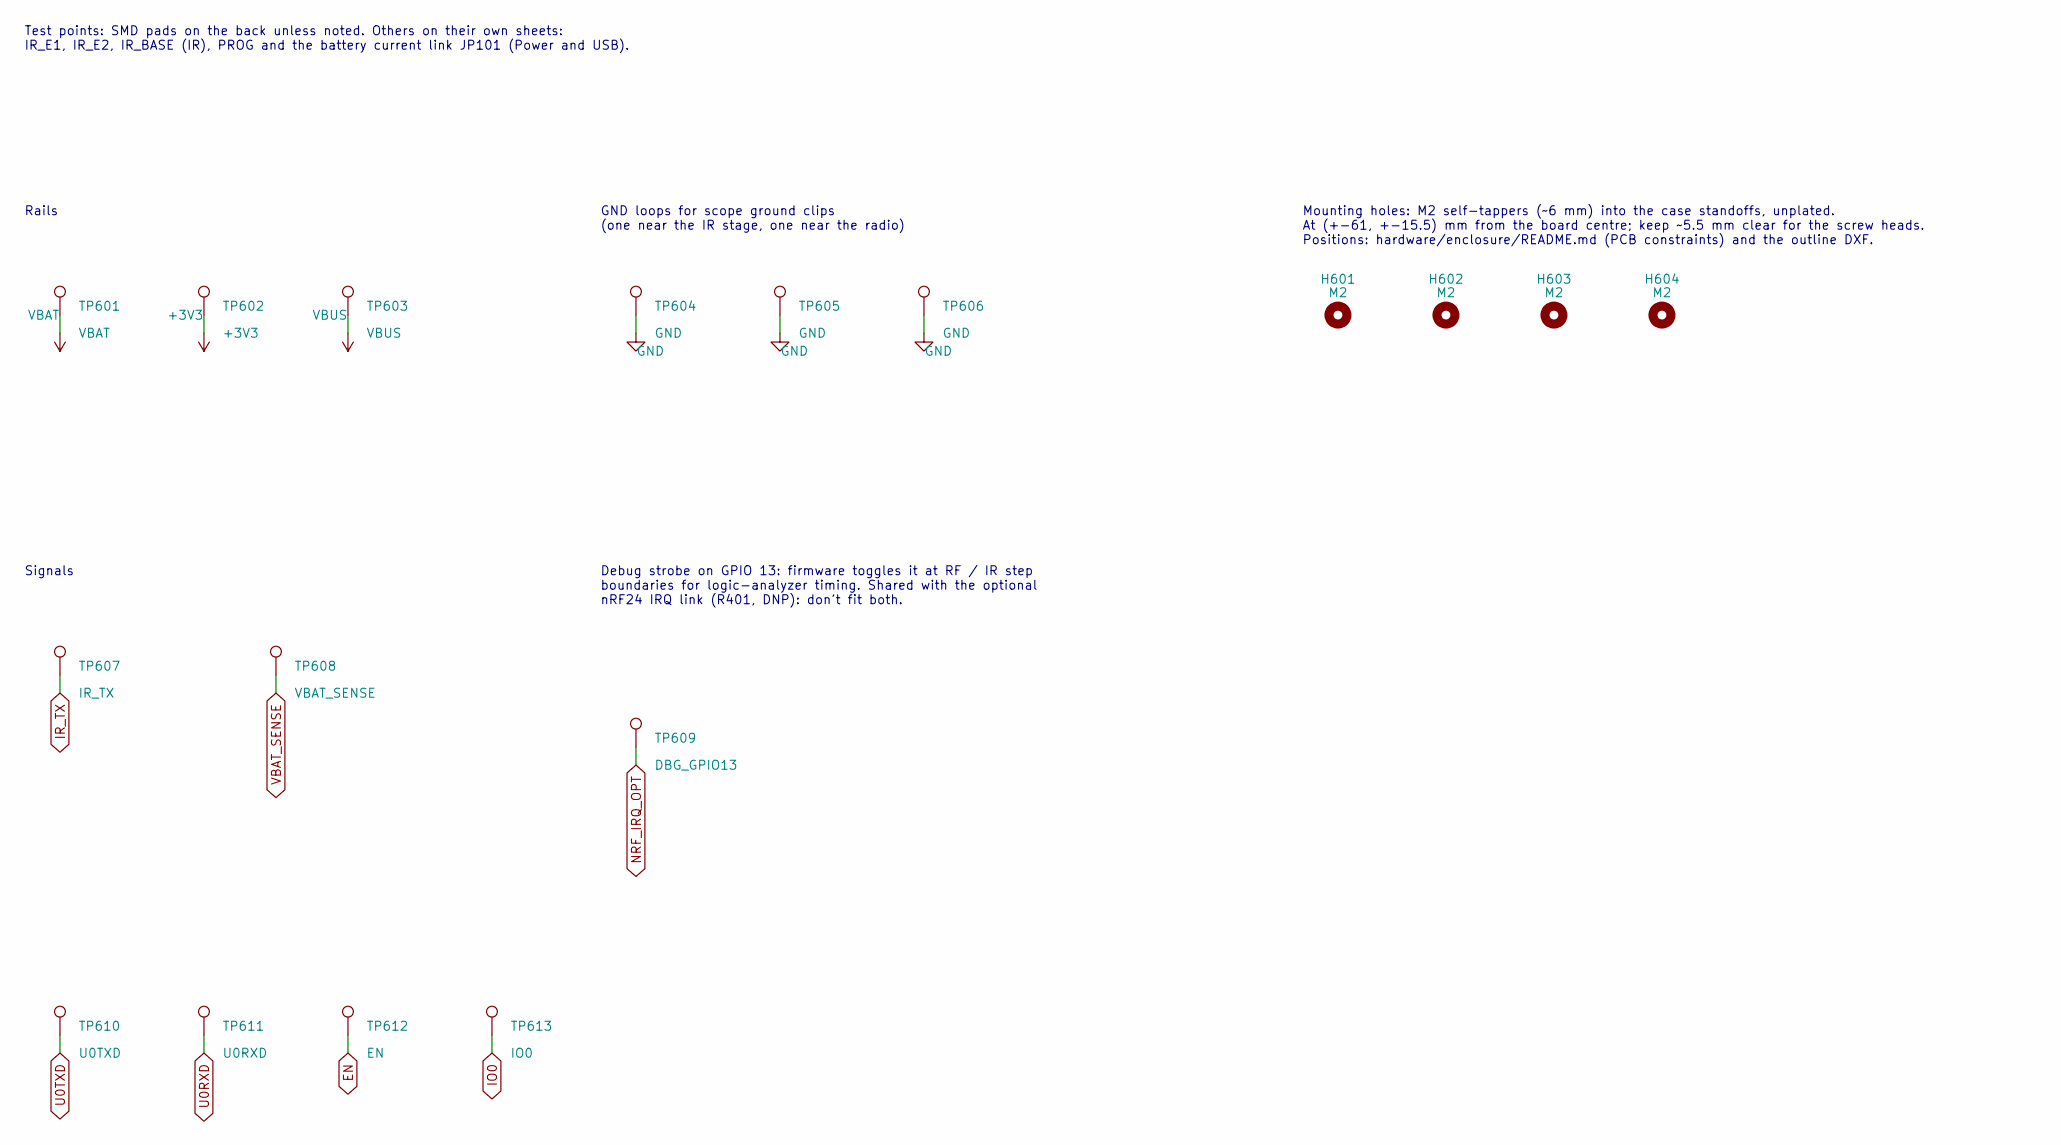
[picture p20: schematic test.kicad_sch, HD Platinum remote replacement: Test and debug]

Parts:
H601, H602, H603, H604: M2; MountingHole_2.2mm_M2
TP601: VBAT; TestPoint_Pad_D1.5mm
TP602: +3V3; TestPoint_Pad_D1.5mm
TP603: VBUS; TestPoint_Pad_D1.5mm
TP604, TP605, TP606: GND; TestPoint_Keystone_5000-5004_Miniature
TP607: IR_TX; TestPoint_Pad_D1.5mm
TP608: VBAT_SENSE; TestPoint_Pad_D1.5mm
TP609: DBG_GPIO13; TestPoint_Pad_D1.5mm
TP610: U0TXD; TestPoint_Pad_D1.5mm
TP611: U0RXD; TestPoint_Pad_D1.5mm
TP612: EN; TestPoint_Pad_D1.5mm
TP613: IO0; TestPoint_Pad_D1.5mm

Connections:
+3V3: TP602.1; also elsewhere on the board
EN: TP612.1; also elsewhere on the board
GND: TP604.1, TP605.1, TP606.1; also elsewhere on the board
IO0: TP613.1; also elsewhere on the board
IR_TX: TP607.1; also elsewhere on the board
NRF_IRQ_OPT: TP609.1; also elsewhere on the board
U0RXD: TP611.1; also elsewhere on the board
U0TXD: TP610.1; also elsewhere on the board
VBAT: TP601.1; also elsewhere on the board
VBAT_SENSE: TP608.1; also elsewhere on the board
VBUS: TP603.1; also elsewhere on the board

Notes on the sheet:
Signals
GND loops for scope ground clips (one near the IR stage, one near the radio)
Debug strobe on GPIO 13: firmware toggles it at RF / IR step boundaries for logic-analyzer timing. Shared with the optional nRF24 IRQ link (R401, DNP): don't fit both.
Rails
Test points: SMD pads on the back unless noted. Others on their own sheets: IR_E1, IR_E2, IR_BASE (IR), PROG and the battery current link JP101 (Power and USB).
Mounting holes: M2 self-tappers (~6 mm) into the case standoffs, unplated. At (+-61, +-15.5) mm from the board centre; keep ~5.5 mm clear for the screw heads. Positions: hardware/enclosure/README.md (PCB constraints) and the outline DXF.
