digamesystems/HD_Remote_Clone/hardware/hd_remote/hd_remote.kicad_pcb

## KiCad design hardware/hd_remote/hd_remote.kicad_pcb (continued)

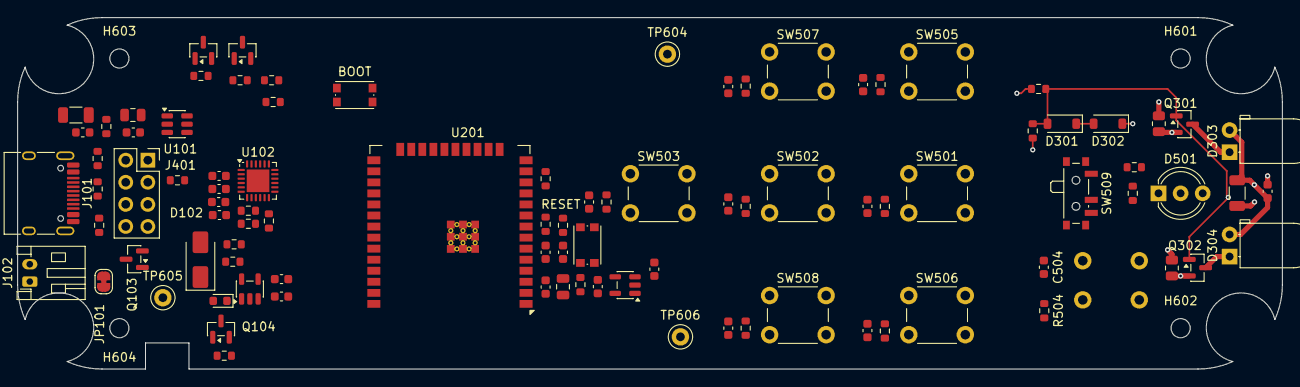
[picture p21: board hd_remote.kicad_pcb from above]

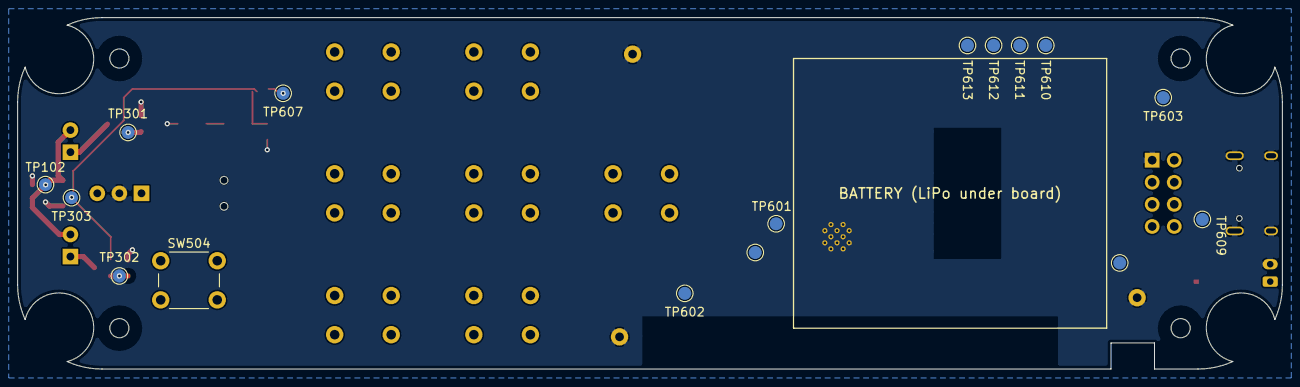
[picture p22: board hd_remote.kicad_pcb from below]

Board: 2 copper layers, 145.4 x 40.4 mm, 114 parts (16 on the bottom side), 57 nets.
