digamesystems/HD_Remote_Clone/src/rf_tools.h

// SPDX-License-Identifier: GPL-2.0-or-later
#pragma once
#include <Arduino.h>

namespace rf {

void begin();

// Repeated SPI/register check on the attached module, per data rate. PASS
// needs clean channel/PA read-back and 2 Mbps (the Platinum remote's rate).
void selfTest(int moduleLabel);
void printDetails();

// Carrier-detect (RPD) sweep over channels 0..125. Prints one row per pass.
void startScan();
// Listen on the current config and print received payloads.
void startSniff();
// Loopback: radio B (pins.h) sends `count` beacon packets with the current
// config while the main radio receives, then prints sent/received.
// Returns false for a bad count.
bool startBeacon(int count);
void stop();

// Remote ID (2 bytes) used in wake frames. Saved in flash (NVS), never in the
// source, since it pairs a remote with the shades.
bool hasRemoteId();
bool setRemoteId(const String& hex);  // 4 hex digits, e.g. "12 34" or "1234"
void clearRemoteId();
void printRemoteId();
// Blocking: sends the red-mode wake frame (ID 01 00 80) on ch 33/52/71 in
// rotation for `ms`, as the original remote does while an arrow is held. The
// shade ignores IR without it. Returns false if no ID is set or no radio.
bool sendWake(uint32_t ms);
// Blocking: wake frames on one channel only, for `ms` (at least one packet).
// Prints nothing on success. Returns the packet count, or -1 on error.
long sendWakeOn(uint8_t channel, uint32_t ms);
// Blocking: a group command as the remote sends it in green mode: ID 20 GROUP
// A1/A2 for `holdMs` (the arrow held), then the 21/22 release tail for
// `tailMs`, rotating ch 33/52/71. group: 0x01/02/04/08 or 0xFF (All). RF only.
bool sendGroup(uint8_t group, bool up, uint32_t holdMs, uint32_t tailMs);
// Blocking: setup-mode (group assignment) frames, ID 30|31 GROUP 80 (add: 30,
// remove: 31), on one channel for `ms`, at least one packet. Prints nothing
// on success. Returns the packet count, or -1 on error (no ID or no radio).
long sendSetupOn(uint8_t group, bool add, uint8_t channel, uint32_t ms);
bool busy();  // a scan, sniff or loopback is running
void poll();  // call from loop()

// Config (applied when a scan/sniff starts). Defaults to the Platinum handheld.
void setChannel(uint8_t ch);
bool setRate(const String& s);  // "250k" | "1m" | "2m"
bool setAddressWidth(uint8_t w);  // 2..5 (2 = promiscuous trick)
bool setAddress(const String& hex);  // up to 5 bytes, hex, as seen on air (MSB first)
bool setCrc(uint8_t bytes);  // 0, 1, 2
bool setPayloadSize(uint8_t n);  // 1..32
void presetHd();  // Platinum handheld: ch 33, 2 Mbps, E7E7E7, CRC16, 5 bytes, runs output
void presetPromiscuous(uint8_t preamble);  // 0xAA or 0x55; turns the dup filter on
void setDupFilter(bool on);  // on: print payloads seen 2+ times; off: print runs
void printConfig();

}  // namespace rf
