digamesystems/HD_Remote_Clone/(commit log)

2026-11-07 Scaffold PlatformIO bring-up firmware for HD Platinum remote clone
    Serial-menu firmware for ESP32-DevKitC (WROOM-32D):
    - IR capture/dump (IRremoteESP8266, raw timings) and 40 kHz replay with RAM slots
    - nRF24 module self-test, RPD channel scan, configurable/promiscuous sniffer
    - Pin map in include/pins.h; project notes in CLAUDE.md
2026-11-07 Add three-tier test strategy and hdcore library
    - Move hardware-independent logic (command tokenizing, hex/rate parsing,
    nRF24 address byte order, sniffer dup filter) into lib/hdcore
    - Tier 1: native Unity tests (test_native_parse, test_native_rf), 18 cases
    - Tier 2: on-device suites gated by include/hw_config.h
    (test_device_board, test_device_rf, test_device_ir loopback)
    - Pre-script strips UNIT_TEST in device test builds so IRremoteESP8266
    uses the real (non-stub) implementation
    - TESTING.md documents tiers, gate rules, and manual acceptance checklist;
    README gets Contributing and Testing sections; CLAUDE.md gate updated
2026-11-07 Move IR receiver to GPIO 32, add serial capture logger, update hardware notes
    - IR RX GPIO 14 -> 32 (user wiring); button UP swapped to GPIO 14 (RTC-capable)
    - scripts/serial_log.py: send commands to the firmware and log output to captures/
    - CLAUDE.md: Gikfun VS1838B receivers, round-dot receivers, logic analyzer
    (working in PulseView), analyzer-first RF plan
    [hw_config.h, pins.h, serial_log.py]
2026-11-07 Decode HD IR protocol; add frame codec, send command, captures
    IR protocol (red mode) reverse engineered from the original remote:
    header 2.75/2.75 ms + 4 bits (1.03 ms mark; 1.03/2.75 ms space), 17.19 ms
    frames repeated while held; UP = 0101, DOWN = 0110 (log + logic analyzer).
    - lib/hdcore/hd_ir: frame encode/decode/summarize (phase-shift and
    truncation tolerant) + 13 Tier 1 tests using real captured frames
    - Firmware: 4096-entry capture buffer, per-capture HD summary line,
    `ir quiet`, `send <up|down|bbbb> [ms]`
    - test_device_ir: HD burst loopback decode case (hardware-gated)
    - captures/: serial logs and PulseView .sr files now committed
    - Docs: CLAUDE.md findings, TESTING.md (A1 part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
2026-11-07 Document IR protocol and remote key/mode behaviour
    - docs/IR_PROTOCOL.md: frame structure, UP/DOWN codes, timing, burst
    behaviour, measured vs nominal values, evidence, firmware support
    - Only the arrow keys send IR (analyzer-verified); group keys 1-4/ALL are
    RF-only and open an RF window during which arrows act as RF
    - TESTING.md: acceptance A1 complete
    - README/CLAUDE.md: link protocol doc, update goals and status
2026-11-07 Document A/B switch, RF window behaviour, and shade power setup
    - A/B switch selects a second group bank (8 groups); no effect on IR
    - Arrows in green mode send no IR; RF window ~6.5 s, restarted by group keys
    - Shades are battery models converted to always-on DC (same firmware);
    RF-wake hypothesis reassessed as open, slight lean toward IR-alone
2026-11-08 Echo serial input; note kit arrival, community goal, foil-shield test
    - main.cpp: echo typed characters, handle backspace, drop non-printables,
    so commands are visible in pio device monitor and serial logs.
    - CLAUDE.md: Bridgold kit arrived; community contribution as a project
    goal; planned foil-shield RF wake-up test.
2026-11-08 Speed up cpd: separate device-test env, faster upload
    - New env:esp32dev_test (extends esp32dev) with its own build folder, so
    test and app builds stay incremental instead of clobbering each other
    (~12 s each vs ~3 min full rebuilds).
    - esp32dev ignores tests; docs updated to `pio test -e esp32dev_test`.
    - upload_speed = 921600.
2026-11-08 Move IR receiver to GPIO 14 (button UP to 32); add `pin` logic probe
    - pins.h: IR RX 32 -> 14, button UP 14 -> 32 (still RTC-capable for ext1
    wake). Pin map, netlist and test/config comments updated.
    - New `pin <gpio> [ms]` command: polls a pin and reports start/end level,
    edge count and % time low. Refuses flash, IR TX and nRF24 output pins.
2026-11-09 Add IR channel B codes, PC arrow keys, send limit; record shade tests
    Firmware:
    - Name all four IR codes (A/B UP/DOWN) in capture and send output.
    - Limit `send` to 5 s for OPEN codes; the manual says a 6 s OPEN hold can
    reset a shade.
    - PC Up/Down arrow keys send up/down on channel A for 500 ms per press,
    using a new KeyParser in lib/hdcore. Tests added, not yet run.
    Docs:
    - The A/B switch is the IR channel selector, not an RF group bank: capture
    shows switch B sends 1001/1010. Manual lists 4 groups, not 8.
    - Record the Nov 8 clone and foil shade tests and manual notes.
    Known issue: the recorded RF wake-up assessment is overstated. These shades
    are top-down/bottom-up with reversed a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
    [main.cpp]
2026-11-09 Record foil-tube shade tests: IR needs RF alongside it; add # comments
    - Foil-tube ("burrito") test: the original remote's IR decodes cleanly
    at 30 cm from inside the tube, but neither IR nor RF moves the shade
    until the remote is unwrapped. RF wake-up is now well supported, not
    proven; the RF burst itself hasn't been captured.
    - Correct the Nov 8 assessment: these shades are top-down/bottom-up with
    reversed arrows, so the `send down` test may have had no travel.
    - Add test logs (captures/ir_shield_tests_20261109.log) and photos
    (docs/images/).
    - Lines starting with '#' are log comments: echoed, no error, and they
    don't stop a running capture. hd::isComment in li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
    [main.cpp]
2026-11-09 Enable IR loopback device tests (LED aimed at receiver on breadboard)
    t2 passed: test_device_ir 3/3, test_device_board 3/3; nRF24 tests skipped.
    [hw_config.h]
2026-11-09 Adopt Platinum RF settings; confirm IR needs the remote's RF
    Shade tests (2026-11-09):
    - Clone IR + original remote RF (remote aimed away): the shade moves and
    follows the clone when the two disagree. Clone alone: 0 of 20. So our
    IR encoding is correct and the red-mode RF is an enable.
    - One RF enable arms one IR command, including repeats and stop, and the
    IR must follow within about 1 s. A clone must send RF before every IR
    command. A2 and A5 now pass.
    RF firmware:
    - Default to the Platinum handheld settings published by
    spitcool/hd-platinum-rf: ch 33/52/71, 2 Mbps, address E7E7E7, CRC-16,
    5-byte payload. New `hd` preset; `promisc` stays as a fallback. Drop
    the channel 7 / 1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
    [hw_config.h, main.cpp, pins.h, rf_tools.cpp, rf_tools.h]
2026-11-11 Clone moves the shade on its own: RF wake + IR
    RF sniff (2026-11-11, one hiBCTR nRF24 module on ch 33):
    - The published Platinum settings (spitcool) are confirmed on both our
    remotes. The remotes have different IDs and both move the shade.
    - A red-mode arrow sends `ID 01 00 80` while held: a wake frame with no
    direction. One remote adds a `01 00 00` tail. A group key alone
    sends nothing.
    - Log in captures/rf_sniff_20261111.log, IDs redacted.
    Clone-only shade test: a 450 ms wake on ch 33/52/71, then IR, moves the
    shade with no original remote, including stops. Reliable with the LED
    about 1 ft from the sensor eye; misses come from IR aim.
    - `id <hex>` stores the remote ID in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
2026-11-11 Interleave RF and IR on the arrow keys (`seq`)
    The PC arrow keys now send RF on ch 33, IR, RF on ch 52, IR, RF on ch 71,
    IR. `seq rf|gap|ir <ms>` sets the RF per channel (default 50 ms), the
    pause before each IR (0) and the IR per step (170 ms). `seq off` restores
    one 450 ms wake on all channels followed by 500 ms of IR. A timing line
    is printed after each sequence. New rf::sendWakeOn() sends on one
    channel.
    Hand-held result (2026-11-11): worked every time at more than 6 ft, and
    aiming felt much less critical than with the old pattern. Not yet a
    controlled result: CLAUDE.md and IR_PROTOCOL.md log the test plan, an A/B
    of the two patterns at a fixed, marginal aim and then a sweep of the
    gap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
    [main.cpp, rf_tools.cpp, rf_tools.h]
2026-11-11 Add handheld board design spec (draft)
    docs/HARDWARE.md describes the battery handheld that will replace the
    original remote, for review before the KiCad schematic:
    - ESP32-WROOM-32E, 1-cell LiPo with USB-C charging (MCP73831) and a
    low-quiescent LDO (RT9080).
    - CP2102N USB-serial bridge with auto-reset, powered from VBUS only, so
    early revisions can be flashed and debugged over USB.
    - 7 keys like the original plus a recessed SETUP button, all on RTC GPIOs
    for ext1 deep-sleep wake; an A/B channel switch.
    - Two TSAL6200 IR LEDs on VBAT, each with a transistor current sink
    (~150 mA, held roughly constant from 3.3 to 4.2 V; to be verified on
    the breadboard first).
    - A 2x4 socket for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
2026-11-11 Note a XIAO ESP32-S3 as a possible later board revision
    The WROOM design uses 22 of 26 usable GPIOs, too many for a XIAO (11). A later revision could fit by putting all 8 buttons on one ADC pin through a resistor ladder (any press also wakes the chip) and dropping the IR receiver footprint. The XIAO's USB-C and LiPo charger would replace the CP2102N and charger. WROOM first.
2026-11-12 Pair the clone with a shade under its own ID (`pair`)
    Sniffed setup-mode group assignment on the working remote (group 4):
    - SETUP, the group key and the save press send nothing.
    - Setup + OPEN (add): ID 30 08 80 while held, plus the normal OPEN IR (0101).
    - Setup + CLOSE (remove): ID 31 08 80, then ID 31 08 00, plus the normal
    CLOSE IR (0110). Aimed away from every shade, it removed nothing.
    New firmware command `pair <1-4|all> <add|remove>` sends the setup frames
    interleaved with the OPEN / CLOSE IR (seq timings, no tail), using the
    stored id. With a made-up ID at a group-4 shade: no group response before
    pairing; `pair 4 add` made the shade jog; then `grp 4` worked 5/5 up and
    5/5 down.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
2026-11-12 Start the handheld KiCad project: Power and USB sheet (draft)
    hardware/hd_remote/ is a KiCad 10 project for the handheld in
    docs/HARDWARE.md. The root sheet links to the first sub-sheet,
    power_usb.kicad_sch:
    - USB-C (sink, 5.1k on CC1/CC2) with USBLC6 ESD protection.
    - CP2102N USB-serial, bus-powered only, with a VBUS sense divider, an RST
    pull-up, 1k in series on TXD/RXD, and the DevKitC two-transistor
    auto-reset to EN / IO0.
    - MCP73831 charger (~250 mA) with a charge LED, JST-PH battery connector.
    - RT9080 3.3 V LDO (drawn with the AP2112K symbol, same pinout) and the
    1M/1M battery divider to VBAT_SENSE.
    ERC: no errors; four warnings for the labels to the ESP32, which connect
    once th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
    [hd_remote.kicad_pcb, hd_remote.kicad_sch, power_usb.kicad_sch]
2026-11-12 Add the MCU sheet (draft); number references by sheet
    hardware/hd_remote/mcu.kicad_sch, page 3: the ESP32-WROOM-32E with
    10 uF + 100 nF decoupling, the EN RC reset (10k / 1u) with a RESET
    button, and a BOOT button on IO0 (new: a fallback if auto-reset fails on
    an early board; added to the spec's pin map). Every GPIO in the pin map
    is on a named global label (BTN_UP, IR_TX, NRF_CSN, ...) for the sheets
    still to come. Strapping pins 2, 12 and 15 are left open; GPIO 13 carries
    NRF_IRQ_OPT.
    Both sheets had numbered parts from 1 (two U1s, and so on). schgen now
    takes a per-sheet reference base: 1xx Power and USB, 2xx MCU. The Power
    and USB sheet was regenerated for that (it had not been edited i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
    [hd_remote.kicad_sch, mcu.kicad_sch, power_usb.kicad_sch]
2026-11-12 Add the IR sheet (draft)
    hardware/hd_remote/ir.kicad_sch, page 4, from the spec's IR transmitter:
    - IR_TX (GPIO 4) -> 470 ohm -> a shared base node clamped at ~1.3 V by
    two 1N4148W in series.
    - Two channels: TSAL6200 from VBAT into a BC817-40, 4.3 ohm 0805 emitter
    resistor, ~150 mA each. LED footprint bent 90 degrees, out of the
    board edge.
    - 100 uF + 100 nF on VBAT at the LEDs.
    - Optional TSOP382xx receiver with 100 ohm / 100 nF supply filter, DNP.
    New beyond the spec (recorded in it): a 100k pull-down on the base node,
    so the LEDs can't turn on while GPIO 4 floats during boot or deep sleep.
    schgen: parts can be marked DNP. ERC: unchanged (3 expected errors
    until the buttons sheet e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
    [hd_remote.kicad_sch, ir.kicad_sch]
2026-11-12 Complete the schematic draft: nRF24, buttons/LEDs, test points
    New sheets (ERC on the whole design: 0 errors, 0 warnings; every GPIO
    net in the netlist matches the spec's pin map):
    - nRF24 (4xx): 2x4 socket numbered as on the module; supply through
    FB401 (0 ohm fitted, ferrite-bead option) to NRF_VCC with 10 uF +
    100 nF, a DNP 100 uF for a PA/LNA module, and a DNP 0 ohm IRQ link to
    GPIO 13.
    - Buttons and LEDs (5xx): 8 keys to 3V3 with 100k pull-downs (100 nF
    debounce DNP), the A/B slide switch on GPIO 21, and the red/green
    common-cathode indicator (330 / 270 ohm). Key footprints are
    placeholders until the enclosure is chosen.
    - Test and debug (6xx): VBAT/3V3/VBUS pads, three GND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
    [hd_remote.kicad_sch, ir.kicad_sch, nrf24.kicad_sch, power_usb.kicad_sch, test.kicad_sch, ui.kicad_sch]
2026-11-12 Document the clone's IR drive measured at the LED
    Scope across the breadboard LED's 33.8 ohm series resistor (2026-11-12):
    - Carrier 39.7 kHz at ~50 % duty (IRremoteESP8266's default, not the
    ~33 % first assumed), 2.96 V peak = 88 mA, flat tops.
    - `send up 1` / `send down 1` each give exactly one frame; both decode
    as expected (0101 / 0110). Bit 0 shows as where the last mark sits
    within the fixed 17.19 ms frame.
    docs/IR_PROTOCOL.md: new section with the three screenshots
    (docs/images/scope_clone_ir_*_20261112.png), the decode table, and a
    pointer from the older uncalibrated trace; the status table separates
    our clone's measured carrier from the remote's (still unmeasured).
    docs/HARDW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
    [ir.kicad_sch]
2026-11-12 License the hardware and docs; add SPDX tags
    Completes the licensing started with the GPL v2 LICENSE (85c1296):
    - Firmware and tools: GPL-2.0-or-later (root LICENSE). SPDX line added
    as the first line of all 33 C++ and Python files we wrote.
    - KiCad design: CERN-OHL-S-2.0, hardware/LICENSE (verbatim from CERN).
    - Docs, captures and images: CC-BY-SA-4.0, docs/LICENSE (verbatim
    legal code from creativecommons.org).
    README.md: new License section (scope table, third-party library
    licenses, spitcool facts cited not copied). hardware/README.md: license
    note. CLAUDE.md: licensing rules for future work (SPDX on new files,
    license texts verbatim, manual paraphrase only, binaries link source,
    DC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
2026-11-12 Address schematic review: nRF24 pulls, reverse polarity, R_E
    From a design review (2026-11-12):
    - nRF24 sheet: R402 100k pull-up on CSN, R403 100k pull-down on CE, so
    the radio stays deselected and idle while the ESP32 boots or sleeps.
    - Power sheet: Q103 AO3401A P-FET in the battery lead (gate to GND)
    blocks a reversed cell; the charger still charges through it. JP101
    now feeds VBAT_JP; the note asks for +/- silkscreen at J102.
    - IR sheet: R_E 4.3 -> 3.3 ohm. The first draft assumed Vbe = 0.65 V;
    a BC817-40 needs ~0.75-0.8 V at 150 mA, so 4.3 ohm would give only
    ~110-120 mA. Final value to be set on the breadboard.
    New parts placed last, so existing references keep their numbers.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
    [ir.kicad_sch, nrf24.kicad_sch, power_usb.kicad_sch]
2026-11-13 Add 3D-printed enclosure: build123d setup and clamshell case model
    hardware/enclosure/ holds code-CAD for the handheld's case (build123d,
    viewed live in VS Code with OCP CAD Viewer). The venv lives outside
    Dropbox, which locks files mid-install; README.md has the setup steps,
    and requirements.txt pins build123d 0.13.0 and ocp_vscode 4.2.0.
    parts/remote_box.py (preliminary, most sizes placeholders): a
    150 x 45 x 27 mm clamshell split at the IR LED axis, in MJF nylon.
    - Bottom shell: floor, 4 board standoffs (M2 through the board), a
    support pad under each key switch so the board doesn't flex, and the
    lower halves of the LED and USB-C openings. The battery (placeholder
    503035) lies unde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
2026-11-13 Enclosure: original's key layout, keycaps, A/B slider, fit checks
    Top face now follows the original Hunter Douglas remote (manual
    photos): indicator at the tip, CHANNEL A/B slider, one oval for the
    UP/DOWN arrows (two caps, two switches), groups 1/2 and 3/4 beside
    the arrows, ALL below. SETUP is a pinhole in the floor near the front,
    over a 5 mm switch on the board's underside.
    - Keycaps: separate parts with a retaining flange under the face,
    1.5 mm proud, 0.1 mm clear of the plungers; legends recessed 0.4 mm
    (arrows; 1-4 and ALL reading upright) for a white paint fill.
    - A/B: printed knob and fork over a side-actuated SMD slide switch
    (MSK12C02 / PCM12, 1.5 mm travel).
    - Corner radiu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
2026-11-13 Enclosure: round the top and bottom edges (2.5 mm)
    The case's top and bottom perimeter edges are rounded at 2.5 mm,
    smaller than the 12 mm vertical corners, for a softer, less boxy shape.
    The edges are rounded before the case is hollowed, so the wall follows
    the curve; 1.8 mm of material remains through it (measured). All 31
    fit checks in assembly.py pass. First cut of the case design.
2026-11-13 Enclosure: battery connector, lead path and retention; reset notes
    - Battery leads: the JST PH socket (S2B-PH-K) sits on top of the board,
    back right, mouth facing forward; the leads run from the plug down
    through a 5 x 3 mm notch in the right-hand board edge (128-133 mm
    from the front) to the cell under the board. The top shell's lip
    gets a gap there. Modelled as keep-outs in assembly.py.
    - Battery retention: four L-shaped corner ribs on the floor (1.5 mm
    tall, 0.5 mm clearance), sides left open for the leads, removal and
    swelling; plus a thin tape pad and an insulating sheet on the board's
    underside (assembly steps, recorded in the README).
    - assembly.py: 46 fit checks, now c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
2026-11-13 Enclosure views; original remote reference and FCC filing notes
    hardware/enclosure/views.py regenerates documentation views from the
    model into docs/images/enclosure/: PCB constraints (top view with
    outline, notches, standoffs, part positions and keep-outs), lengthwise
    sections with height marks, top/bottom/end views, a board-outline DXF
    for KiCad's Edge.Cuts, and two shaded screenshots from the viewer
    (finished look; exploded see-through). The README's new Views section
    shows them. assembly.py: screenshot views reset the camera.
    docs/HARDWARE.md, the original Platinum remote, described rather than
    reproduced (its images stay out of the repo):
    - layout of the front and back, and how our cas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
    [enclosure_pcb_outline.dxf]
2026-11-13 Enclosure: apply review changes (legends, keycap play, USB plug pocket)
    From an external review of the first cut:
    - Legends recessed 0.8 mm (was 0.4) so MJF's grain doesn't fill them
    and the white paint has a clean channel; digits 4.5 mm, ALL 4.0 mm.
    - Keycap play at rest 0.3 mm (was 0.1). MJF is +-0.3 mm per part, and
    shims under the board can only reduce the gap, so start large and
    tune on the print. The flange stays 0.8 mm, with a 0.2 mm relief
    pocket over each plunger.
    - Outside pocket round the USB-C opening (12.5 x 7 x 1 mm) so a plug's
    moulded housing can sink in by the 1 mm recess and the plug seats.
    - IR LEDs: the review suggested flush; kept 1.5 mm proud for version 1
    (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
    [enclosure_pcb_outline.dxf]
2026-11-13 Enclosure: retake the shaded views after the review changes
    The finished and exploded screenshots now show the current model
    (0.8 mm legends, 0.3 mm keycap play, USB-C plug pocket). Regenerated
    with views.py; the drawings were unchanged.
2026-11-13 Enclosure test piece; board and case assembly; key switch sourcing
    hardware/enclosure/parts/test_piece.py: an MJF tolerance print that
    turns the model's placeholder values into measured ones. Sizes come
    from remote_box.py, so the samples test what the case uses:
    - plate (2 mm floor, 2 mm wall): IR LED holes 5.2/5.4/5.6 mm with the
    countersink, the USB-C opening and plug pocket, screw pilots
    1.6/1.8/2.0 mm, SETUP pinholes 1.4/1.6/1.8 mm, legends 0.4/0.6/0.8 mm
    deep; every sample labelled;
    - key fixture: base holding one real 13 mm switch at the case's board
    height, a 2 mm face screwed on at the case's exact spacing, and caps
    with 0.0/0.1/0.2/0.3 mm play, marked on top.
    23 checks. --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
2026-11-13 Record the enclosure test piece order
    The first MJF test print (7 parts from parts/test_piece.py, PA12
    natural grey) was ordered from JLC3DP on 2026-11-13, from the STLs
    exported at 76482ef. CLAUDE.md notes what's needed to run the test
    procedure on arrival.
2026-11-13 Note the tactile switch assortment on hand
    A BOJACK 6 x 6 mm THT assortment (heights 4.3-13 mm) is on hand: its
    5 mm part serves as the SETUP switch for prototype 1, and its 13 mm
    part can stand in for the test fixture, once its leg spacing, height,
    plunger diameter and travel are measured. The Same Sky 5 mm part
    becomes optional; its DigiKey number and stock are recorded.
2026-11-13 Schematic: sync with the enclosure; CP2102N and RT9080 datasheet checks
    - Mounting holes H601-H604 (M2, unplated) on the Test and debug sheet
    - Same Sky TS02 MPNs on the key switches; low-profile nRF24 socket note on J401
    - CP2102N (data sheet rev 1.3): C103 on VDD/VIO 1u -> 4.7u (4.7u + 100n per
    power pin); VBUS divider, RSTb pull-up and pinout confirmed
    - R107 (ESP32 TX0 -> CP2102N RXD) 1k -> 10k: limits back-powering of the
    unpowered CP2102N to ~0.27 mA (RXD abs. max is VIO + 2.5 V)
    - RT9080 (DS9080-09): pinout, EN tied to VIN and caps confirmed
    - Spec: enclosure decision updated; sleep-budget caveats (TX0 pull-up,
    pin states before sleep, cell drain outside JP101)
    ERC: 0 violation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
    [nrf24.kicad_sch, power_usb.kicad_sch, test.kicad_sch, ui.kicad_sch]
2026-11-13 Schematic: LCSC part numbers; basic-part resistor swaps
    - LCSC field on all 77 machine-placed parts (JLC catalogue via jlcsearch,
    each confirmed by C number); hand-soldered THT parts left blank
    - R104/R105 VBUS divider 22.1k/47.5k -> 22k/47k (3.40 V vs 3.41 V on the
    CP2102N VBUS pin) and R110 R_PROG 4.02k -> 3.9k (~256 mA): JLC basic parts
    - RESET/BOOT: KMR221NGLFS (4.2 x 2.8 mm, fits the 4-pad KMR2 footprint);
    A/B: PCM12SMTR; charger MCP73831T-2ACI/OT
    - Spec: LCSC notes and the parts to check before layout
    ERC: 0 violations.
    [ir.kicad_sch, mcu.kicad_sch, nrf24.kicad_sch, power_usb.kicad_sch, ui.kicad_sch]
2026-11-13 Layout: footprints from the schematic, board outline and mounting holes
    - All 109 footprints and 82 nets pulled into the PCB, linked to their
    symbols by UUID (DRC schematic parity: 0 issues); parked off-board
    - Board outline from the enclosure DXF (145.45 x 40.45 mm, front at +X);
    M2 holes H601-H604 locked at (+-61, +-15.5) mm
    - U201: ground-pad vias widened from 0.2 to 0.3 mm drill (JLC standard);
    expected lib_footprint_mismatch, don't update it from the library
    - Test pads and JP101 excluded from the BOM, matching their footprints
    [hd_remote.kicad_pcb, ir.kicad_sch, power_usb.kicad_sch, test.kicad_sch]
2026-11-13 Layout: place the case-fixed parts, keep-outs, first-pass placement
    - Keys, SETUP (underside), IR LEDs, indicator, A/B, USB-C, battery JST,
    ESP32 and nRF24 socket placed and locked at the enclosure model's
    coordinates
    - Keep-outs: battery (rule area + hd_remote.kicad_dru: no THT component
    pins over the cell, plated vias allowed), key support pads, screw heads
    and standoffs, nRF24 antenna
    - SETUP moved 10 mm right of centre (case model SETUP_Y = -10): on the
    centre line its pins hit the A/B switch's pads; all 51 case checks pass,
    drawings regenerated
    - Remaining 89 parts: scripted first-pass placement (nearest free spot to
    connected pads), no courtyard or keep-out errors; to be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
    [hd_remote.kicad_pcb]
2026-11-14 Layout: key area, IR stage and power parts placed by hand; label cleanup
    - Key area: each pull-down/debounce pair beside its switch
    - IR stage: Q301/Q302 beside their LEDs, emitter resistors 2 mm from the
    emitters, 100 uF bulk cap between the LED anodes, test pads together
    under the front centre
    - Indicator resistors at D501, U301 filter at U301, LDO caps at U104,
    ESP32 decoupling near its 3V3 pin, nRF24 supply filter at J401
    - Silkscreen: reference labels hidden on most R/C (kept for the key
    pairs); labels moved clear of pads and parts
    - Still parked off the board: USB/serial, charger, nRF24 caps, ESP32
    reset network (29 parts)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
    [hd_remote.kicad_pcb]
2026-11-14 Layout: first-draft placement complete
    All parts on the board; DRC has no errors (label warnings only), schematic
    parity clean.
    - USB/serial: ESD U101 between the USB-C and CP2102N; CP2102N clear of the
    nRF24 antenna keep-out, its four supply caps 1.8-3.2 mm from the pins
    (100 nF nearest); UART series resistors and auto-reset pair at U102
    - nRF24: 100 nF / 10 uF at the socket's VCC pin
    - Charger: caps, PROG resistor and charge LED within ~2 mm of U103
    - ESP32: EN cap and battery-sense cap ~2 mm from their pins
    - IR stage, keys, indicator and LDO as in the previous commit
    [hd_remote.kicad_pcb]
2026-11-14 Layout: routing setup (net classes, bottom GND plane)
    - Net classes: HighCurrent 0.6 mm (VBAT, VBAT_BATT, VBAT_JP, IR LED
    cathode/emitter nets), Power 0.5 mm (+3V3, VBUS, NRF_VCC), Default 0.2 mm
    - GND pour on B.Cu over the whole board, 0.3 mm clearance, thermal
    reliefs; no copper in the ESP32 or nRF24 antenna keep-outs or the
    screw-head rings
    - DRC: no errors; through-hole GND pins now connect to the plane
    [hd_remote.kicad_pcb]
2026-11-14 ESP32 rotated 180 degrees; power path (Microchip AN1149)
    ESP32 orientation:
    - Antenna end moved to the -Y board edge so the module's left pin column
    (all the RTC/key pins) faces the keys and its SPI/UART pins face the
    nRF24 socket and CP2102N; 14 key and SPI lines no longer cross
    - 21 parts re-homed (EN, battery-sense and 3V3 decoupling to the new pin
    positions; BOOT, J601, JP101/Q103, charger caps and underside test pads
    out of the module's new footprint and antenna keep-out)
    - Case model: ESP32 placeholder and its lip gap moved to the -Y side;
    51/51 checks pass; drawings regenerated
    Power path:
    - D102 STPS1H100AY (100 V 1 A Schottky, chosen for low reverse leakage),
    Q104 AO340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
    [hd_remote.kicad_pcb, ir.kicad_sch, power_usb.kicad_sch]
2026-11-14 Routing cleanup: drop the UART header J601; re-assign key pins
    - J601 (DNP 1x6 UART fallback header) removed from the schematic and the
    board; its signals keep their real connections. Spec gives a solder-wire
    fallback (R106/R107, C203, SW202, test points) if the CP2102N fails
    - Key GPIOs re-assigned so the key lines fan out from the ESP32's RTC pin
    column without crossing: G1 34->26, G2 35->34, G3 36->27, G4 27->36,
    SETUP 26->35. UP/DOWN/ALL and VBAT_SENSE (GPIO 39) unchanged; one key
    on GPIO 36/39 as before (erratum note added to the spec)
    - Ratsnest crossings 201 -> 159 (135 -> 98 excluding +3V3)
    - ERC 0, schematic parity 0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
    [hd_remote.kicad_pcb, mcu.kicad_sch, test.kicad_sch]
2026-11-14 Layout: untangle the ratsnest by reorienting small parts
    - Scripted local search (rotations in place and nearby same-footprint
    swaps, only where the part stays clear of every courtyard and keep-out):
    ratsnest crossings 98 -> 89 (GND and +3V3 excluded)
    - Key area kept uniform: all key pull-down/debounce pairs vertical, same
    way round (R503 nudged 0.5 mm to clear SW201 and the ESP32)
    - Elsewhere: Q101, Q103, R401, R509, C109, C302 rotated; R112/R113 swapped;
    labels of moved parts re-placed
    - DRC: no errors; schematic parity 0
    [hd_remote.kicad_pcb]
2026-11-14 Remove the optional IR receiver (U301, R305, C303)
    - Schematic: receiver, its 100 ohm + 100 nF supply filter, power symbols,
    IR_VS/IR_RX labels and note removed; ESP32 pin 13 (GPIO 14) is now a
    no-connect and listed as spare
    - Board: footprints removed, zones refilled; also includes small hand
    placement tweaks from the last editor session
    - Ratsnest crossings 90 -> 87, unrouted connections 227 -> 222
    - Spec: decisions, pin map, IR sheet table and DNP notes updated; IR
    capture stays on the breadboard
    - ERC 0, schematic parity 0
    [hd_remote.kicad_pcb, ir.kicad_sch, mcu.kicad_sch]
2026-11-14 Layout: place test pads to minimise ratsnest crossings
    - Scripted search over legal underside spots (clear of parts, THT pins
    and keep-outs) for each test pad; pads now sit by the circuit they test
    (VBUS at the USB-C, VSYS at the IR stage, VBAT at the charger, IR pads at
    the IR stage, VBAT_SENSE at the ESP32 pin)
    - Ratsnest crossings 87 -> 72 (GND, +3V3 excluded); TP602 and the GND
    loops unchanged
    - Labels re-placed, zones refilled; DRC no errors, schematic parity 0
    [hd_remote.kicad_pcb]
2026-11-14 Layout: restore the battery keep-out; ESP32 support parts back at their pins
    - Battery rule area had been dragged 36 mm / 31 mm off the board, which
    silently disabled the no-THT-pins / no-underside-parts check over the
    cell; moved back to 91.5-127.5 mm from the front, +-15.5 mm
    - TP601 and TP101, which had landed over the cell while the keep-out was
    displaced, re-placed at the best legal spots
    - TP602 (+3V3) restored from the schematic, on the underside under the
    regulator output
    - Hand placement: 3V3 decoupling (C202 2.3 mm, C201 4.3 mm), EN cap C203
    and battery-sense cap C109 back beside their ESP32 pins; reset network
    next to them
    - DRC no errors, schematic parity 0; ratsnest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
    [hd_remote.kicad_pcb]
2026-11-14 UART/boot test pads replace the J601 header
    - TP610 U0TXD, TP611 U0RXD, TP612 EN, TP613 IO0 on the Test and debug
    sheet: an external USB-serial adapter can flash and debug the ESP32 if
    the CP2102N or auto-reset fails, without J601's routing cost
    - Placed on the underside by the crossing-minimising script; they ended
    up in a row at 3 mm pitch near the +Y edge, handy for clips or a jig
    - Ratsnest crossings 73 -> 72 despite four new connections; ERC 0,
    schematic parity 0, DRC no errors
    - Spec: test-points table rows and bring-up procedure
    - Also includes small hand placement edits from the previous session
    [hd_remote.kicad_pcb, test.kicad_sch]
2026-11-14 Layout: RESET/BOOT silkscreen labels; battery outline on the bottom silk
    - SW201 and SW202 labelled RESET and BOOT on the top silkscreen (value
    fields made visible), so they read in the 3D view and on the board
    - Bottom silkscreen: outline of the battery keep-out with a centred,
    mirrored "BATTERY (LiPo under board)" label; outline, label and the
    Battery rule area locked so they can't be dragged again
    - Test-pad labels moved off the outline; zones refilled
    - Spec: note on the cell sitting ~1 mm under the ESP32 antenna area
    (no effect while the ESP32 radio is unused; options if it ever is)
    - DRC no errors, schematic parity 0
    [hd_remote.kicad_pcb]
2026-11-14 AB_SW to GPIO 14 via R202; C201 22 uF; reference review; power-symbol fix
    - A/B switch moved from GPIO 21 to GPIO 14 (front-facing pin column), via
    a 10k series resistor R202 in case GPIO 14 drives during boot against the
    switch; net between pin and resistor labelled AB_SW_PIN; R202 placed by
    pin 13 and turned to face it. GPIO 21 is now spare
    - C201 (ESP32 bulk decoupling) 10 uF -> 22 uF (C45783), matching the
    WROOM-32E datasheet reference circuit and the DevKitC
    - Reference design review recorded in the spec: WROOM-32E datasheet v2.1,
    DevKitC V4 schematic, Espressif schematic checklist; KMR2 land pattern
    confirmed against C&K's NG layout
    - Power symbols and flags renumbered uniq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
    [hd_remote.kicad_pcb, hd_remote.kicad_sch, ir.kicad_sch, mcu.kicad_sch, nrf24.kicad_sch, power_usb.kicad_sch, test.kicad_sch, ui.kicad_sch]
2026-11-14 Routing: IR stage complete
    - Both LED loops on top at 0.6 mm: C301/C302 -> anode, cathode ->
    collector (5.6 / 3.3 mm), emitter -> R_E (2.0 mm), GND vias at the pads
    - Base network (R301, R302, D301, D302) at 0.2 mm; IR_BASE to both bases
    and TP303; test pads TP301/TP302/TP102/TP607 by vias
    - VSYS added to the HighCurrent net class (it was created after the
    classes were set up, so it had defaulted to 0.2 mm)
    - No track on the bottom layer; DRC no errors, schematic parity 0;
    204 connections left to route
    [hd_remote.kicad_pcb]
